JJaroll/MacBerry-Pi/docs/README.md

# Documentación

- [`guia_cableado_pi5.md`](guia_cableado_pi5.md) · cableado, pines verificados contra KiCad, jumpers, Raspberry Pi 5, alimentación y pruebas.
- [`guia_macberry_pi.md`](guia_macberry_pi.md) · guía completa de implementación (traducción y adaptación; revisa sus tablas de pines contra la guía anterior).
- [`informe_master_v5.md`](informe_master_v5.md) · informe del PCB master (diseño, comprobaciones, antes de fabricar, logos).
- [`traducciones/`](traducciones) · material del proyecto original traducido al español (README, readmes de carpetas, utilidad de calibración, modelines).
- [`historial/`](historial) · informes de las versiones anteriores (fusión, v2, v3, v4).

Documentación original en inglés: [qbancoffee/imac_g3_ivad_board_init](https://github.com/qbancoffee/imac_g3_ivad_board_init).
