JJaroll/MacBerry-Pi/hardware/contribuciones_rudy/LEEME.md

# Contribuciones de Rudy (reng.ca)

Placas creadas y cedidas por **Rudy** ([reng.ca](https://reng.ca)) al proyecto de qbancoffee para que otros las usen. KiCad (esquema, PCB, Gerber, PDF), sin modificar.

- **RPiG3iMac**: HAT para Raspberry Pi con LEDs de encendido y actividad. Convierte el RS232 TTL entrante a niveles CMOS para el puerto serie de la Pi.
- **RPiG3iMacJ20**: placa adaptadora para las tiras de pines J3 y J5 de la placa J20; permite conectar cables comunes mediante regleta de terminales.

Texto original en inglés traducido: *«Estas placas fueron creadas y generosamente aportadas por Rudy…»* (ver `readme.txt`, ya en español).
