JJaroll/MacBerry-Pi/originales/surfacemount_version/LEEME.md

# Versión SMD de la placa J20 (en desarrollo)

Copia de `schematics_and_pcbs/surfacemount_version` de qbancoffee: versión de montaje superficial de las placas principales, pensada para servicios de ensamblado. Según el autor **está en desarrollo**, por lo que no se ha verificado en este repositorio. Sin modificar (LGPL-3.0).
