JJaroll/MacBerry-Pi/hardware/placas_individuales/DownConverter/esquematico_es/LEEME.md

# Esquema traducido

Archivos KiCad 5 (`.sch`, `-cache.lib`, `.pro`) y BOM del proyecto de qbancoffee con las etiquetas traducidas al español. Para abrirlos usa KiCad 5 o importa el `.sch` en versiones posteriores.
