JJaroll/MacBerry-Pi/originales/imagenes/LEEME.md

# Imágenes del proyecto original

Imágenes de [qbancoffee/imac_g3_ivad_board_init](https://github.com/qbancoffee/imac_g3_ivad_board_init) (LGPL-3.0) usadas por la guía y por el README traducido. Los PNG están optimizados y las **fotos JPG reducidas a un máximo de 1600 px** para aligerar el repositorio; los originales a resolución completa están en el repositorio de qbancoffee.
