JJaroll/MacBerry-Pi/originales/raw_data/LEEME.md

# Datos crudos (raw_data)

Capturas del bus I²C de la placa IVAD (logic analyzer, `captures/`) y volcados EDID (`edids/`) que qbancoffee usó para la ingeniería inversa. Sin modificar (LGPL-3.0); solo se tradujo `captures/display_adjustment_utility/README.txt`. Referencia para quien quiera entender o ampliar la secuencia de inicialización.
