JJaroll/MacBerry-Pi/docs/traducciones/imagenes/analog_board_off.jpg

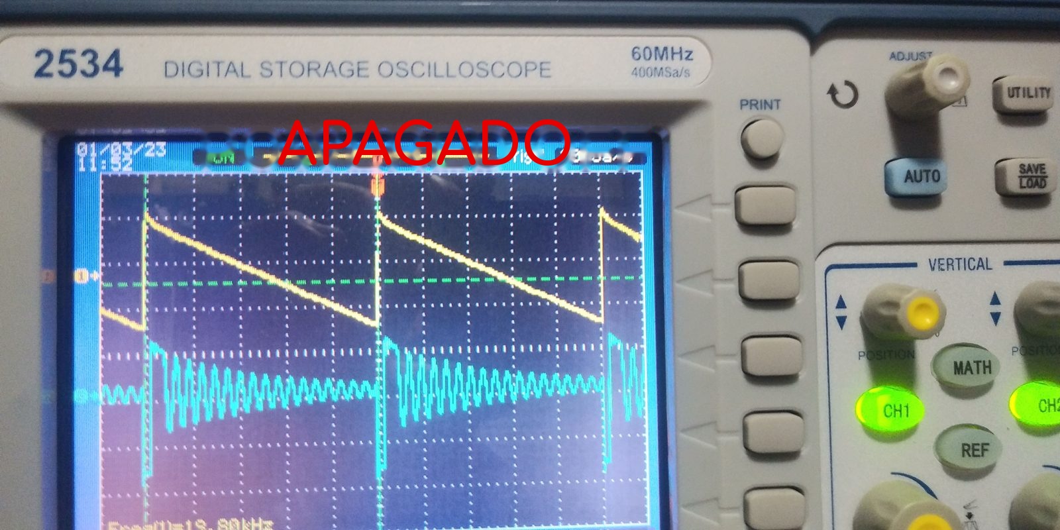
docs/traducciones/imagenes/analog_board_off.jpg
