JJaroll/MacBerry-Pi/docs/traducciones/imagenes/analog_board_on.jpg

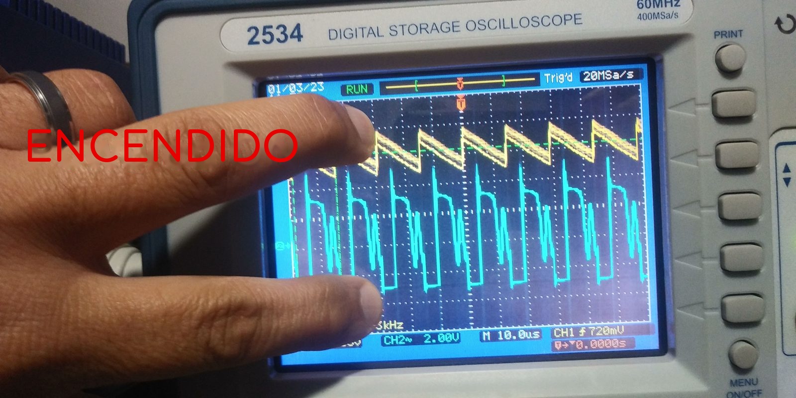
docs/traducciones/imagenes/analog_board_on.jpg
