JJaroll/MacBerry-Pi/docs/traducciones/imagenes/crt_power_on_and_off.png

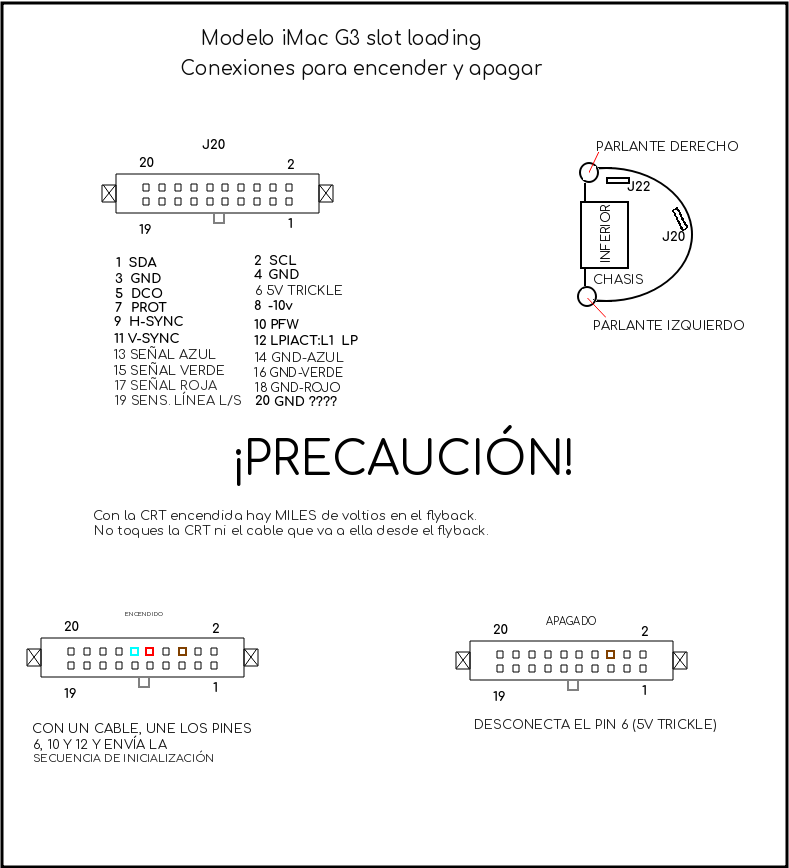
docs/traducciones/imagenes/crt_power_on_and_off.png
