JJaroll/MacBerry-Pi/docs/traducciones/imagenes/J20_and_J22_in_view.jpg

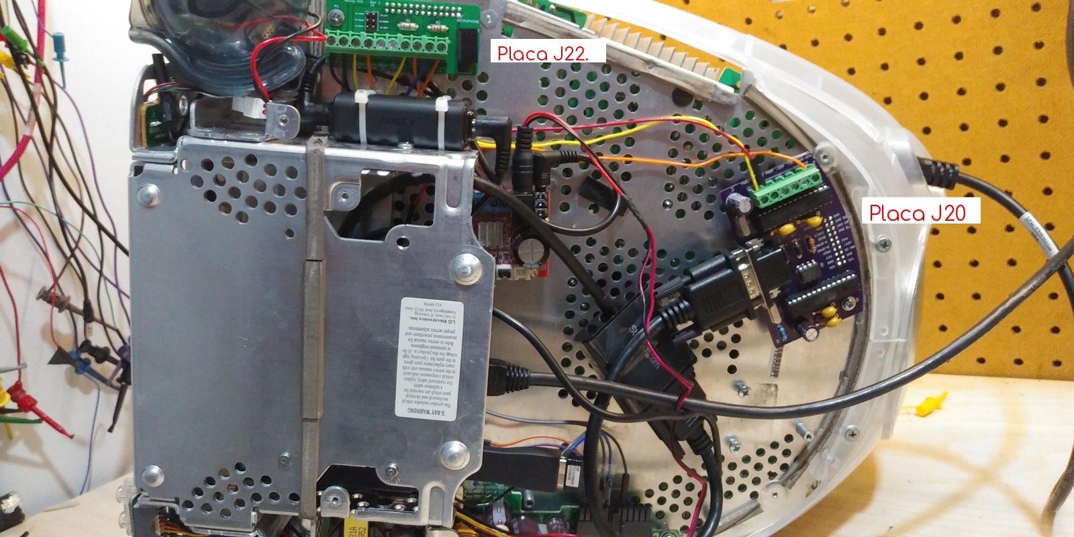
docs/traducciones/imagenes/J20_and_J22_in_view.jpg
