JJaroll/MacBerry-Pi/hardware/master_pcb/vistas_previas/PCB_imac_unificado_master_v5_con_corte_vista_previa.png

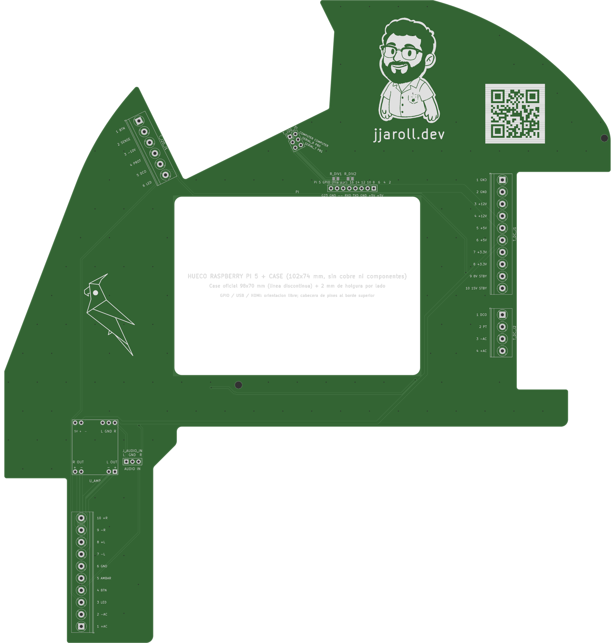
hardware/master_pcb/vistas_previas/PCB_imac_unificado_master_v5_con_corte_vista_previa.png
