JJaroll/MacBerry-Pi/hardware/master_pcb/vistas_previas/PCB_imac_unificado_master_v5_gerber_vista_inferior.png

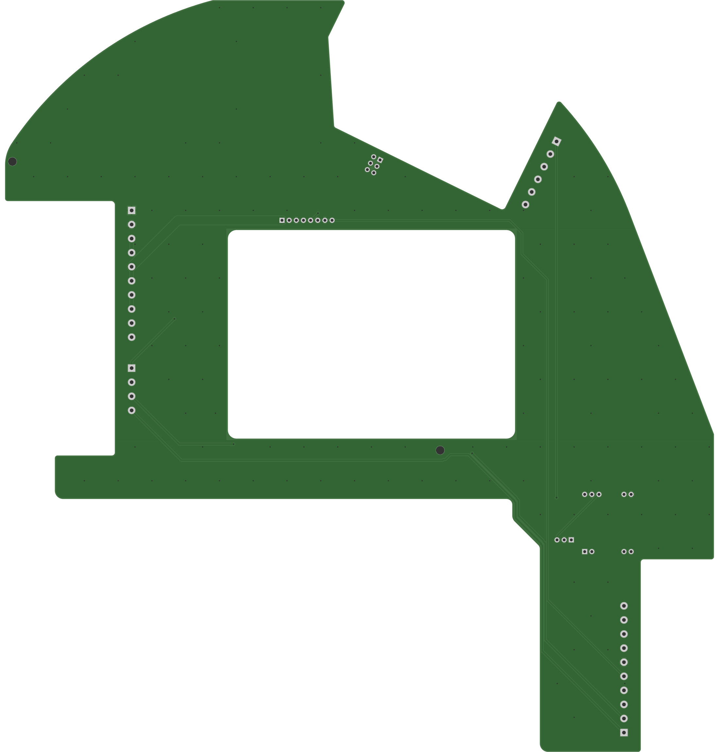
hardware/master_pcb/vistas_previas/PCB_imac_unificado_master_v5_gerber_vista_inferior.png
