JJaroll/MacBerry-Pi/originales/imagenes/down_converter_breakout.jpg

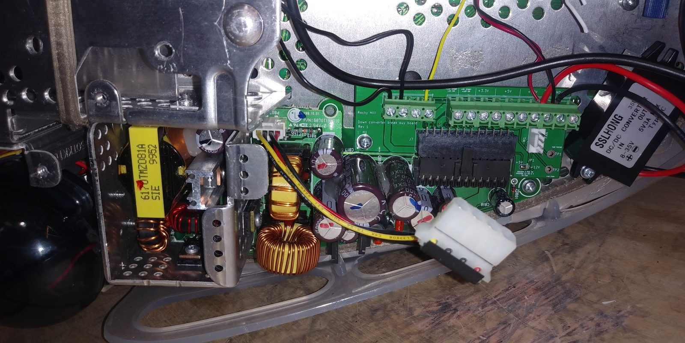
originales/imagenes/down_converter_breakout.jpg
