JJaroll/MacBerry-Pi/originales/imagenes/j20_board.jpg

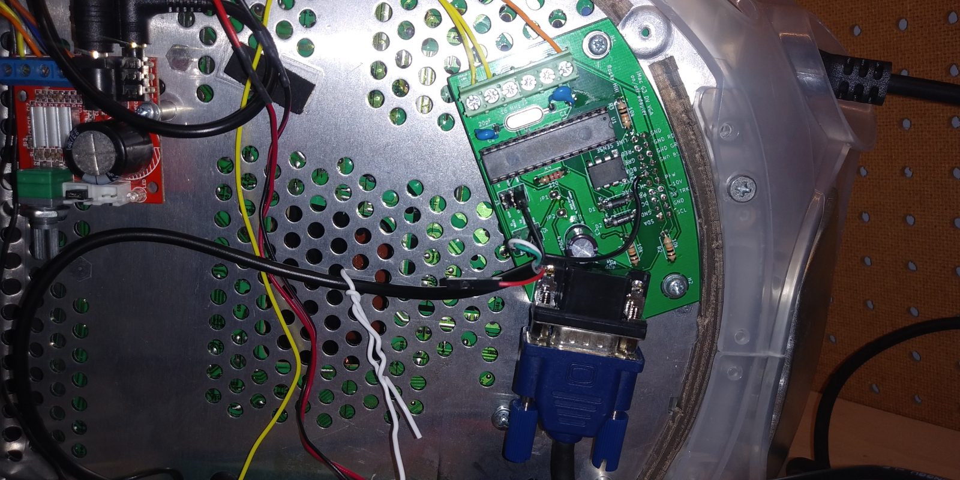
originales/imagenes/j20_board.jpg
