JJaroll/MacBerry-Pi/originales/imagenes/j22_board.jpg

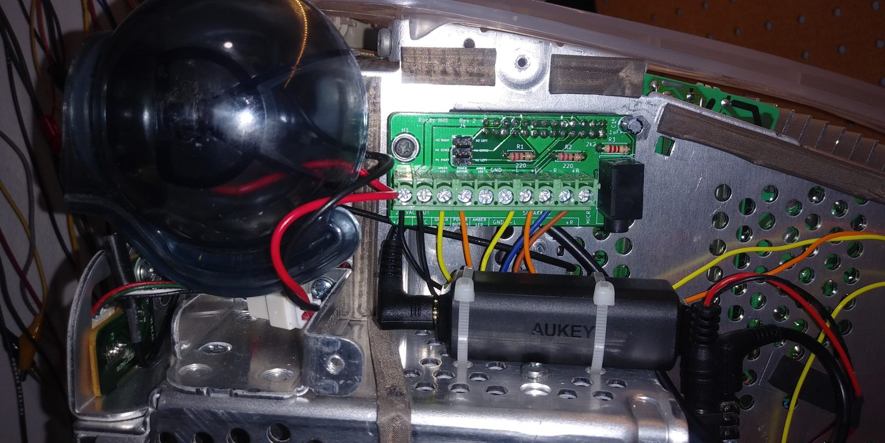
originales/imagenes/j22_board.jpg
