JJaroll/MacBerry-Pi/originales/raw_data/captures/display_adjustment_utility/color/color.jpg

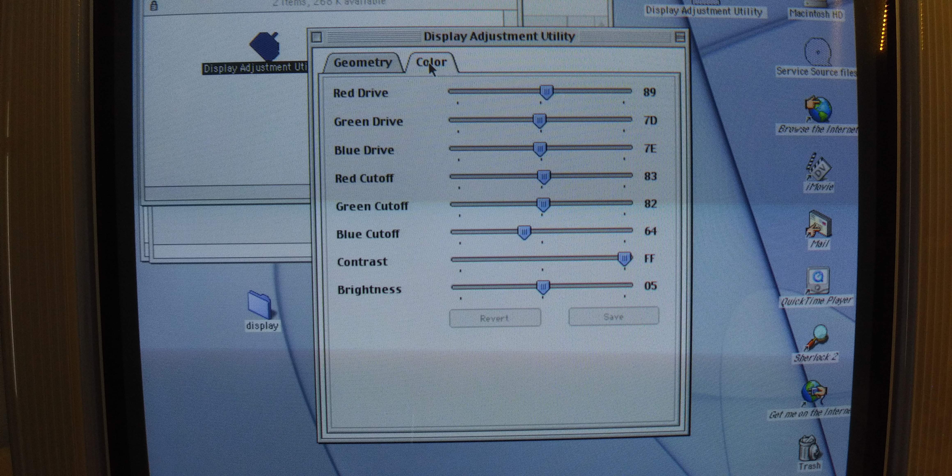
originales/raw_data/captures/display_adjustment_utility/color/color.jpg
