JJaroll/MacBerry-Pi/originales/raw_data/captures/display_adjustment_utility/geometry/geometry.jpg

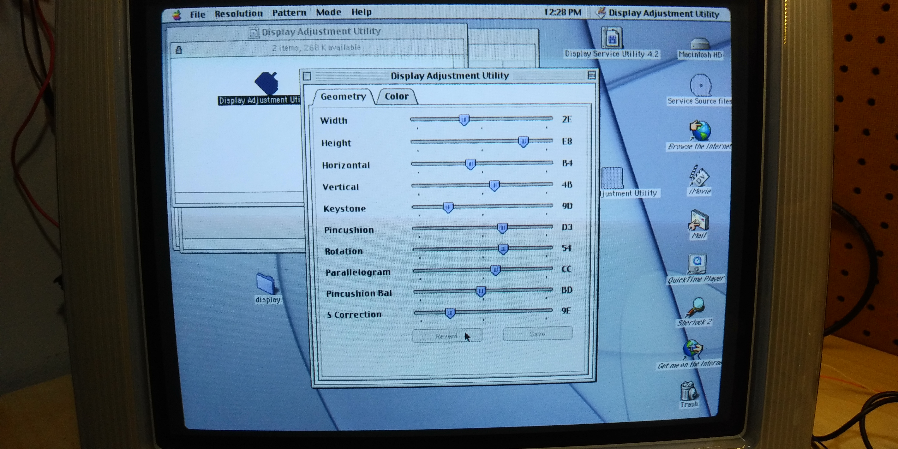
originales/raw_data/captures/display_adjustment_utility/geometry/geometry.jpg
