JJaroll/MacBerry-Pi/sitio/img/placa_dc_inf.png

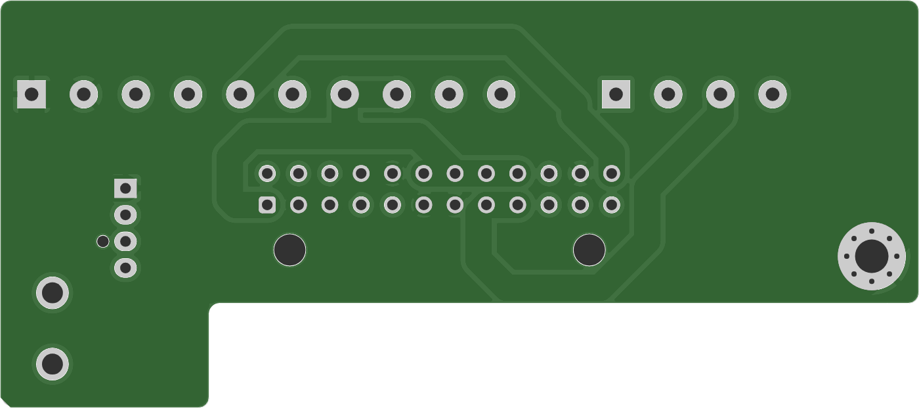
sitio/img/placa_dc_inf.png
