JJaroll/MacBerry-Pi/sitio/img/placa_dc_sup.png

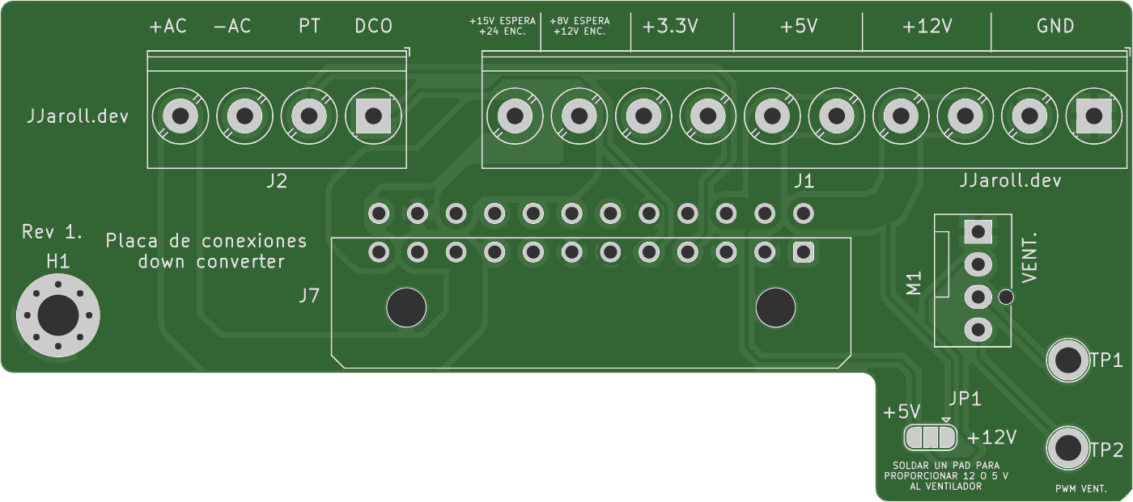
sitio/img/placa_dc_sup.png
