JJaroll/MacBerry-Pi/sitio/img/placa_j20_inf.png

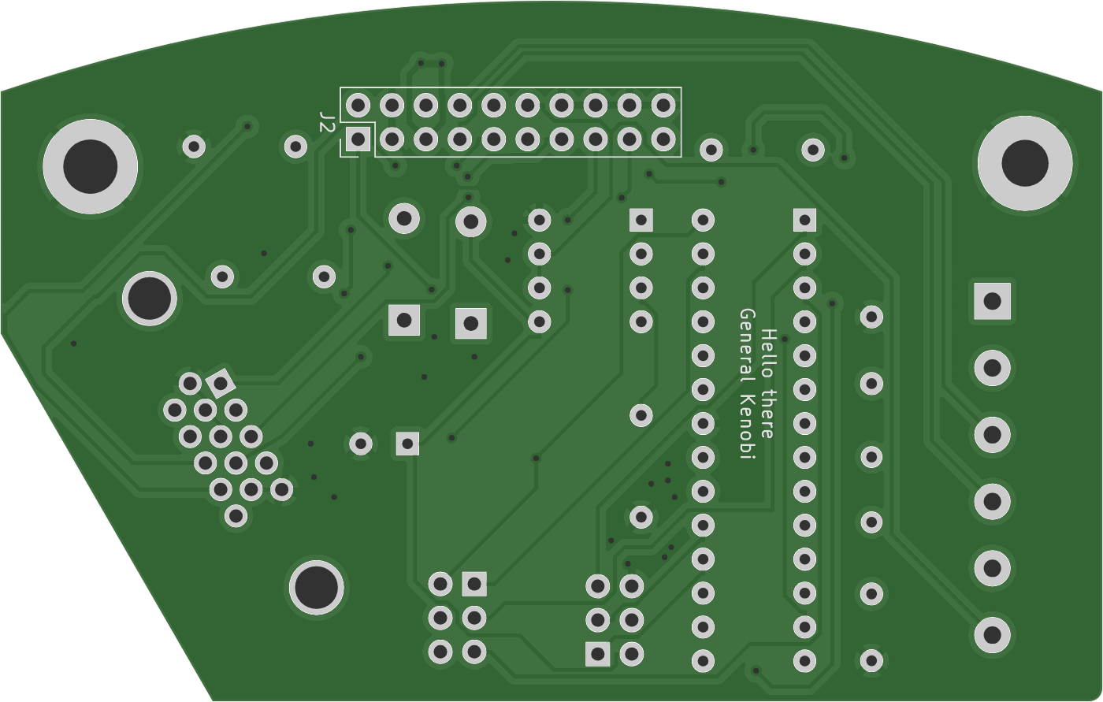
sitio/img/placa_j20_inf.png
