JJaroll/MacBerry-Pi/sitio/img/placa_j20_sup.png

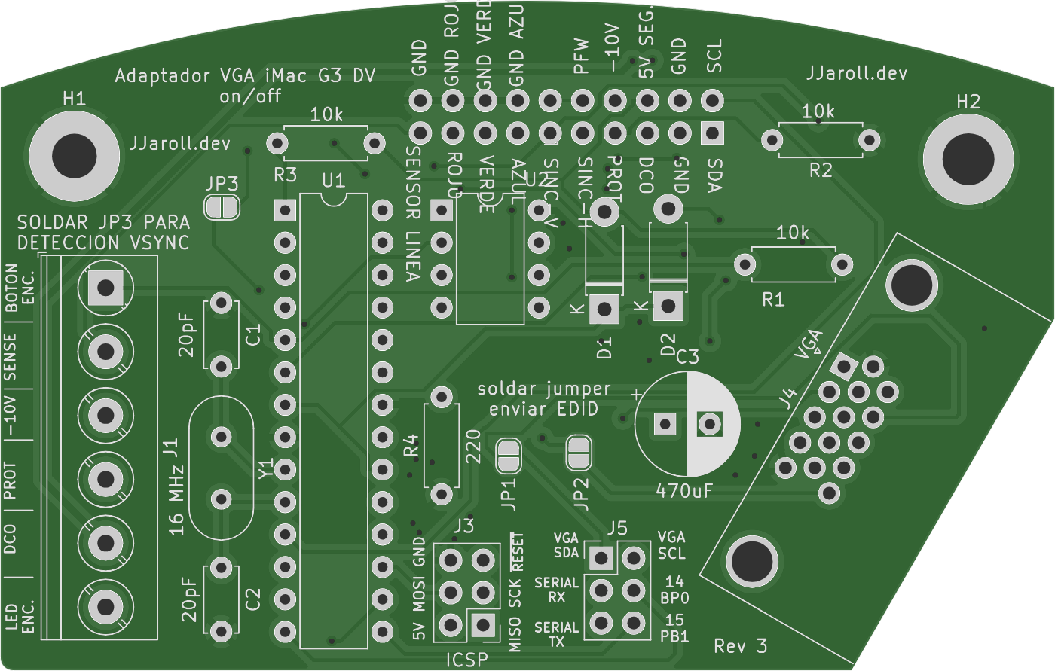
sitio/img/placa_j20_sup.png
