JJaroll/MacBerry-Pi/sitio/img/placa_j22_inf.png

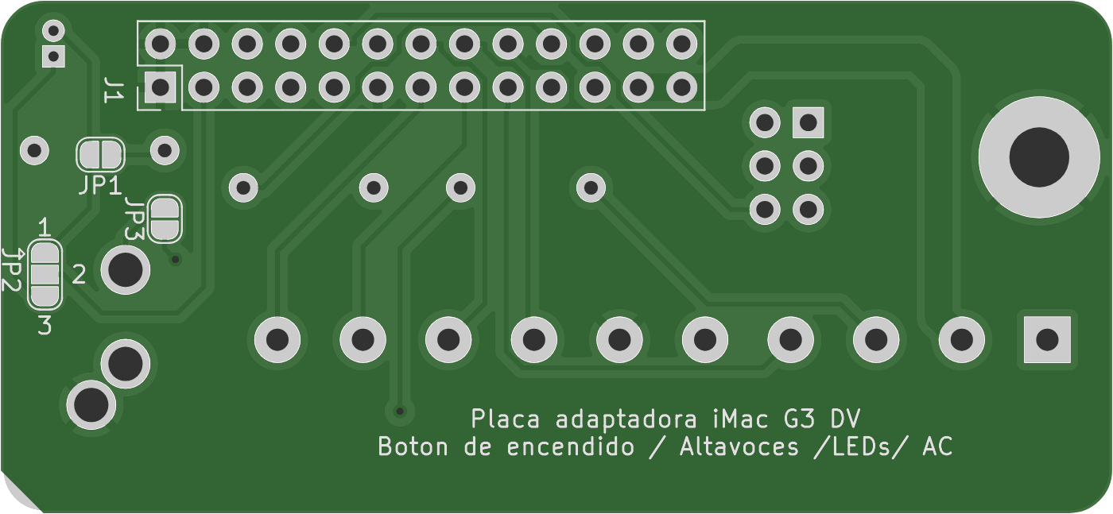
sitio/img/placa_j22_inf.png
