JJaroll/MacBerry-Pi/sitio/img/placa_j22_sup.png

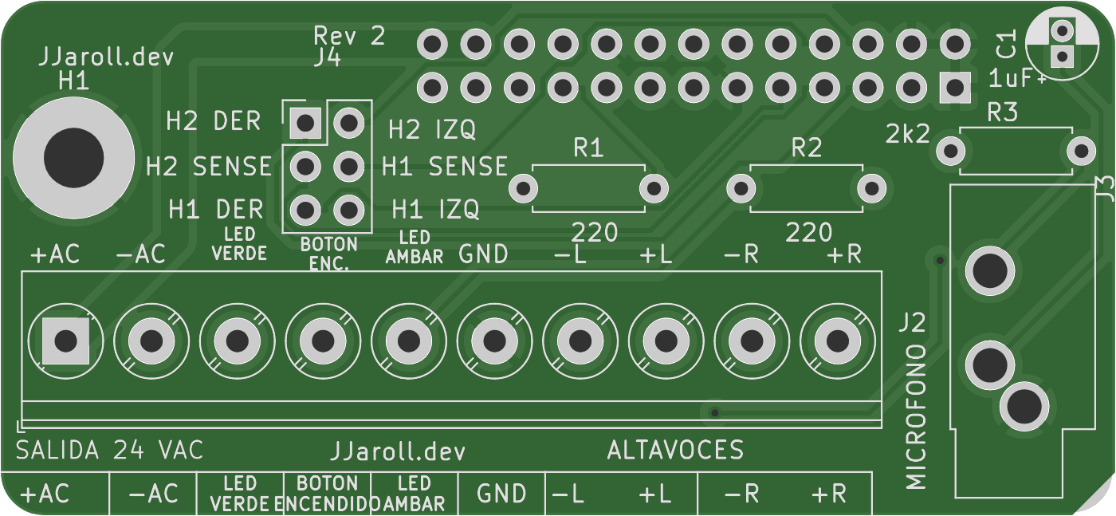
sitio/img/placa_j22_sup.png
