JJaroll/MacBerry-Pi/hardware/placas_individuales/DownConverter/fabricacion/imac_g3_down_converter_board_adapter.csv

Id | Identificador | Huella | Cantidad | Identificación | Suministrador y ref
1 | J1 | TerminalBlock_Phoenix_PT-1,5-10-5.0-H_1x10_P5.00mm_Horizontal | 1 | Screw_Terminal_01x10
2 | J2 | TerminalBlock_Phoenix_PT-1,5-4-5.0-H_1x04_P5.00mm_Horizontal | 1 | Screw_Terminal_01x04
3 | J7 | Molex_Micro-Fit_3.0_43045-2400_2x12_P3.00mm_Horizontal | 1 | Conn_02x12_Top_Bottom
4 | M1 | FanPinHeader_1x04_P2.54mm_Vertical | 1 | Fan_Tacho_PWM
