JJaroll/MacBerry-Pi/hardware/placas_individuales/J22_frontal_audio/fabricacion/imac_g3_slot_loading_J22_adapter_board.csv

Id | Identificador | Huella | Cantidad | Identificación | Suministrador y ref
1 | C1 | CP_Radial_D4.0mm_P1.50mm | 1 | 1uF
2 | J1 | PinHeader_2x13_P2.54mm_Vertical | 1 | Conn_02x13_Odd_Even
3 | J2 | TerminalBlock_Phoenix_PT-1,5-10-5.0-H_1x10_P5.00mm_Horizontal | 1 | Screw_Terminal_01x10
4 | J3 | Jack_3.5mm_CUI_SJ1-3533NG_Horizontal_CircularHoles | 1 | AudioJack3
5 | J4 | PinHeader_2x03_P2.54mm_Vertical | 1 | Conn_02x03_Odd_Even
6 | R1, R2 | R_Axial_DIN0207_L6.3mm_D2.5mm_P7.62mm_Horizontal | 2 | 220
7 | R3 | R_Axial_DIN0207_L6.3mm_D2.5mm_P7.62mm_Horizontal | 1 | 2.2k
