JJaroll/MacBerry-Pi/hardware/master_pcb/PCB_imac_unificado_master_v5_contorno_1a1.dxf

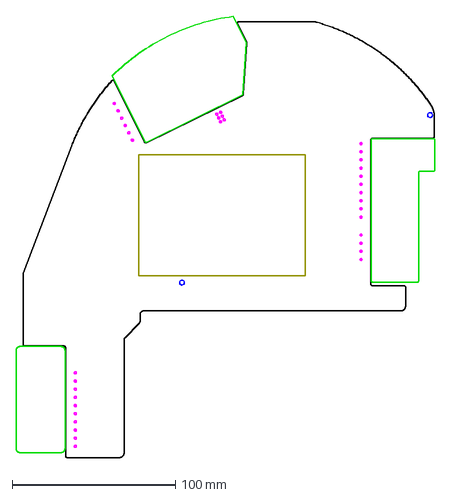
[picture p62: CAD file, 2026-10-20]
hardware/master_pcb/PCB_imac_unificado_master_v5_contorno_1a1.dxf
256.5 x 270.1 mm
