JJaroll/MacBerry-Pi/stl/bezel/Dowel_Bottom.stl

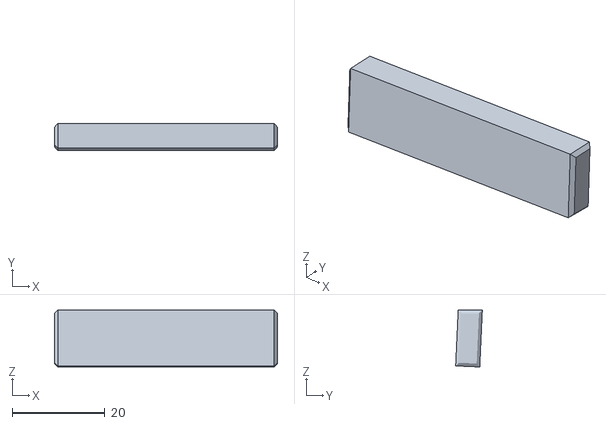
[picture p63: CAD file, 2026-10-20]
stl/bezel/Dowel_Bottom.stl
48.0 x 5.75 x 12.3
