JJaroll/MacBerry-Pi/stl/pcb/placa_DownConverter.stl

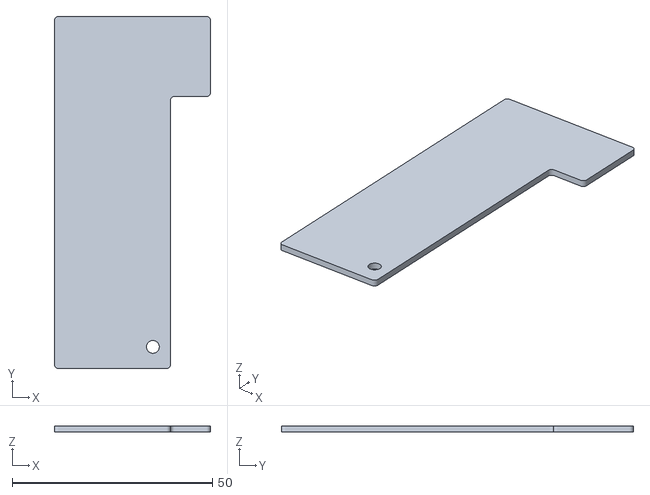
[picture p64: CAD file, 2026-10-20]
stl/pcb/placa_DownConverter.stl
39.0 x 88.0 x 1.60
