JJaroll/MacBerry-Pi/stl/rpi_mount/rpi_g3_plate_v2.stl

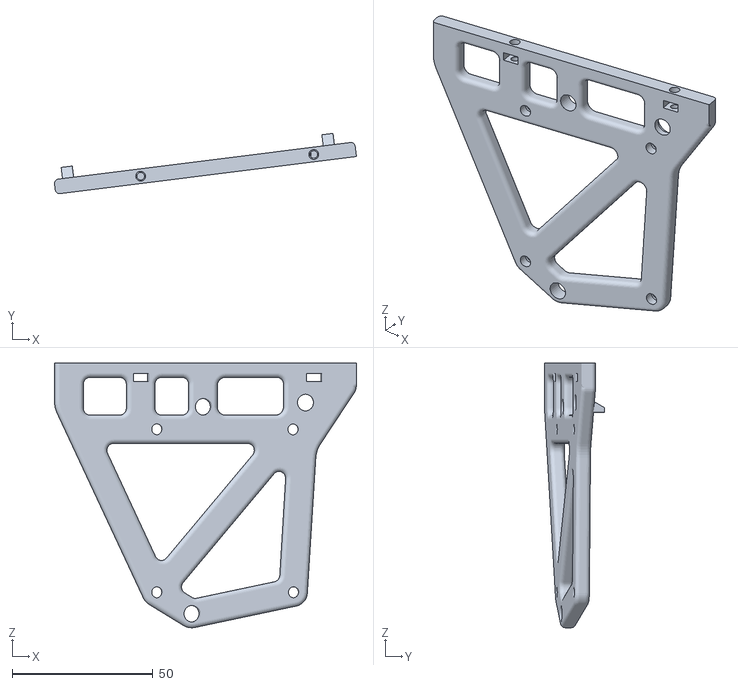
[picture p65: CAD file, 2026-10-20]
stl/rpi_mount/rpi_g3_plate_v2.stl
107.5 x 21.4 x 94.1
