JJaroll/MacBerry-Pi/originales/proyecto_kicad_original/imac_g3_down_converter_board_adapter/3d_models/CUI_DEVICES_SJ1-3533NG.step

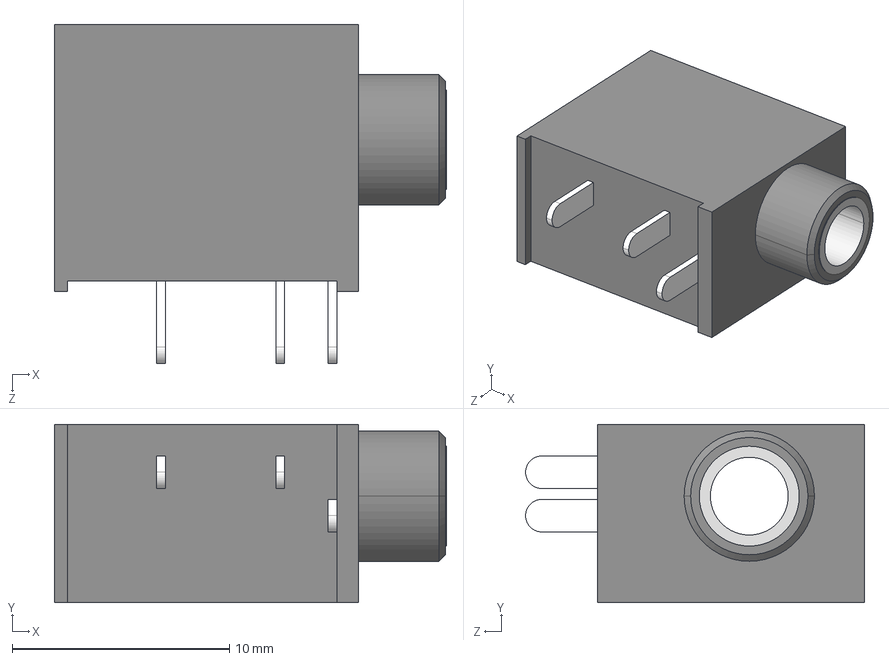
[picture p66: CAD file, 2026-10-20]
originales/proyecto_kicad_original/imac_g3_down_converter_board_adapter/3d_models/CUI_DEVICES_SJ1-3533NG.step
18.1 x 8.20 x 15.6 mm
