JJaroll/MacBerry-Pi/originales/surfacemount_version/imac_g3_333mhz_slot_loading_J20_adapter_board/3d_models/usb_c_connector_105450-0101.step

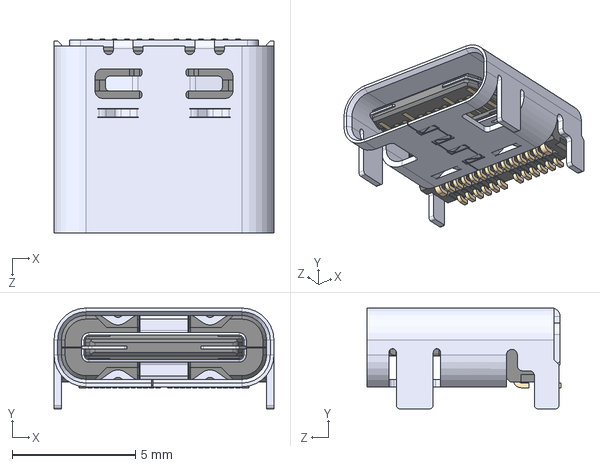
[picture p67: CAD file, 2026-10-20]
originales/surfacemount_version/imac_g3_333mhz_slot_loading_J20_adapter_board/3d_models/usb_c_connector_105450-0101.step
8.94 x 4.10 x 7.90 mm
