JJaroll/MacBerry-Pi/stl/bezel/Top_Right_Supported.stl

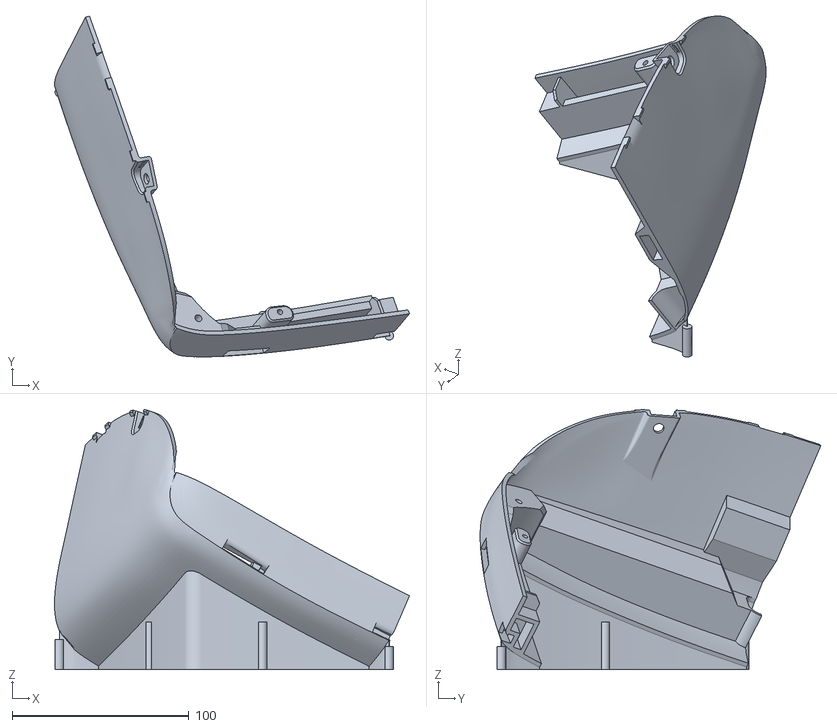
[picture p68: CAD file, 2026-10-20]
stl/bezel/Top_Right_Supported.stl
201.0 x 192.9 x 147.3
