JJaroll/MacBerry-Pi/stl/pcb/master_v5_con_corte.stl

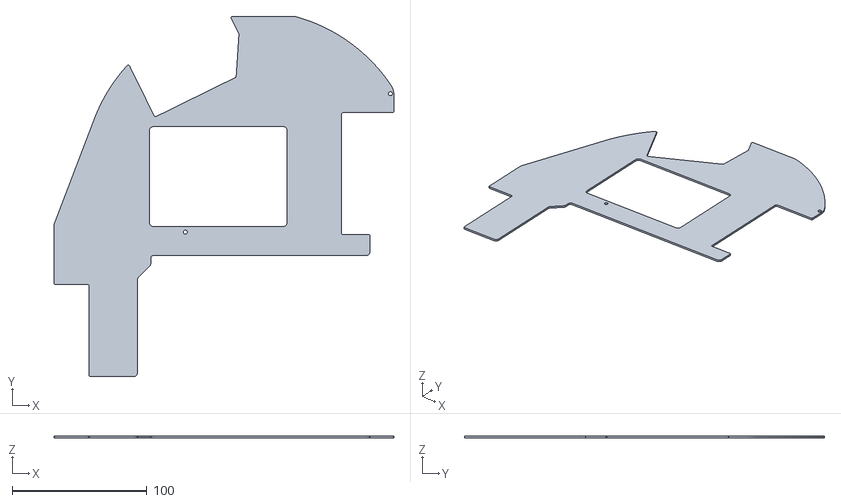
[picture p69: CAD file, 2026-10-20]
stl/pcb/master_v5_con_corte.stl
251.9 x 267.0 x 1.60
