JJaroll/MacBerry-Pi/stl/rpi_mount/rpi_g3_spacer_v1.stl

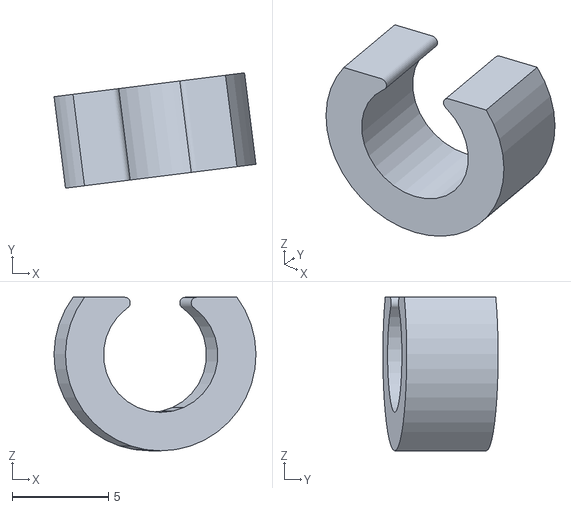
[picture p70: CAD file, 2026-10-20]
stl/rpi_mount/rpi_g3_spacer_v1.stl
10.5 x 6.01 x 8.00
