JJaroll/MacBerry-Pi/originales/surfacemount_version/imac_g3_333mhz_slot_loading_J20_adapter_board/3d_models/USB4105-GF-A.step

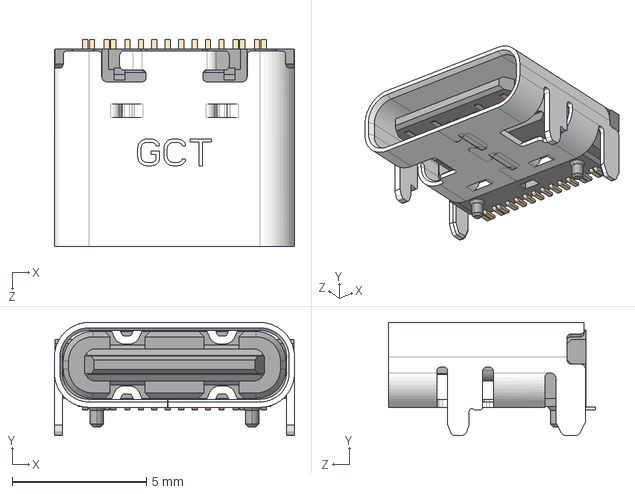
[picture p71: CAD file, 2026-10-20]
originales/surfacemount_version/imac_g3_333mhz_slot_loading_J20_adapter_board/3d_models/USB4105-GF-A.step
8.94 x 4.21 x 7.70 mm
HSG_默认
