JJaroll/MacBerry-Pi/stl/pcb/placa_J22_frontal_audio.stl

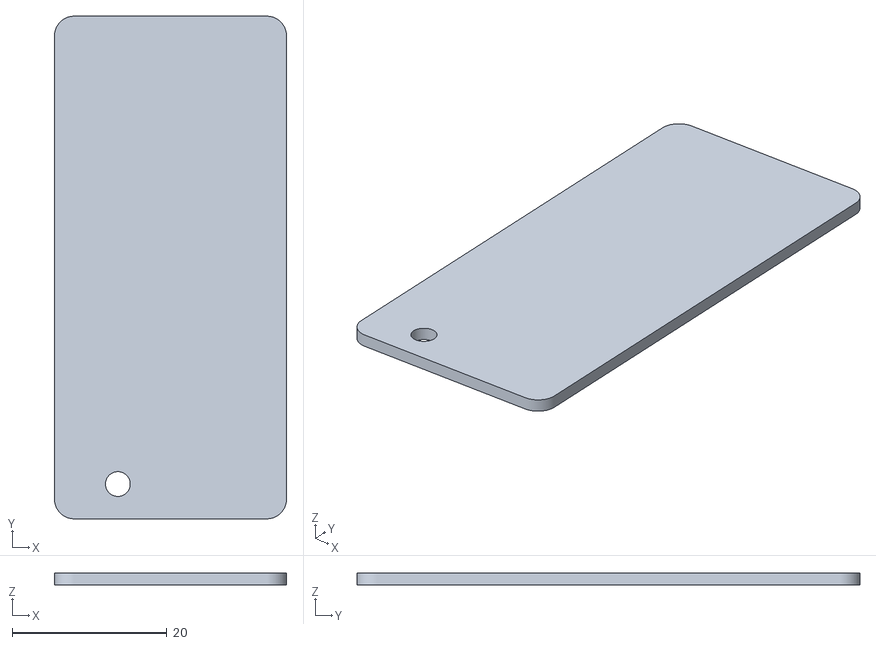
[picture p72: CAD file, 2026-10-20]
stl/pcb/placa_J22_frontal_audio.stl
30.0 x 65.0 x 1.60
