JJaroll/MacBerry-Pi/stl/rpi_mount/rpi_g3_bezel_v3.stl

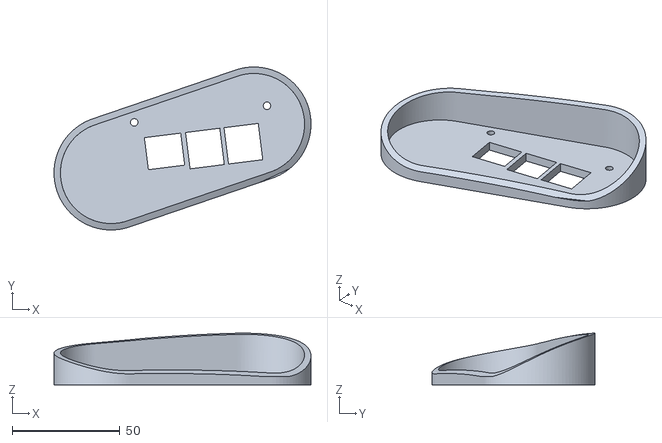
[picture p73: CAD file, 2026-10-20]
stl/rpi_mount/rpi_g3_bezel_v3.stl
119.2 x 75.6 x 24.0
