JJaroll/MacBerry-Pi/stl/pcb/placa_J20_video.stl

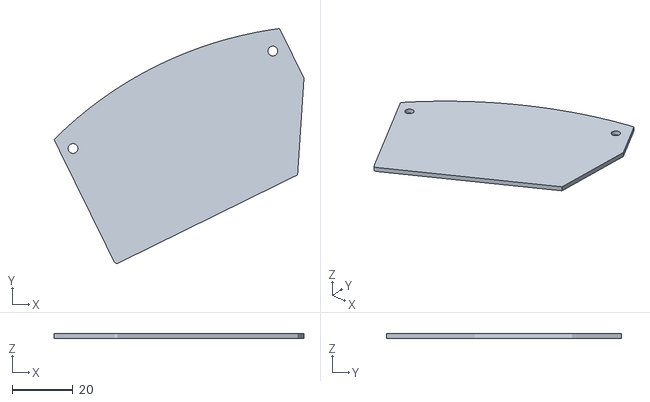
[picture p74: CAD file, 2026-10-20]
stl/pcb/placa_J20_video.stl
82.1 x 77.1 x 1.60
