JJaroll/MacBerry-Pi/stl/bezel/Top_Left.stl

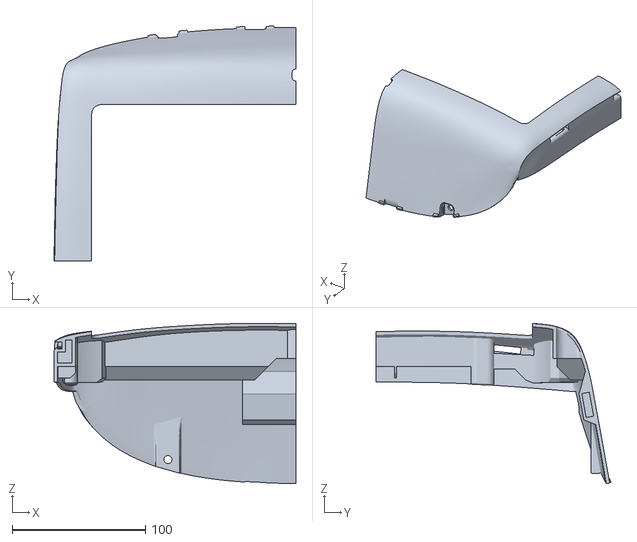
[picture p75: CAD file, 2026-10-20]
stl/bezel/Top_Left.stl
181.3 x 176.0 x 120.2
