JJaroll/MacBerry-Pi/stl/bezel/Power_Button.stl

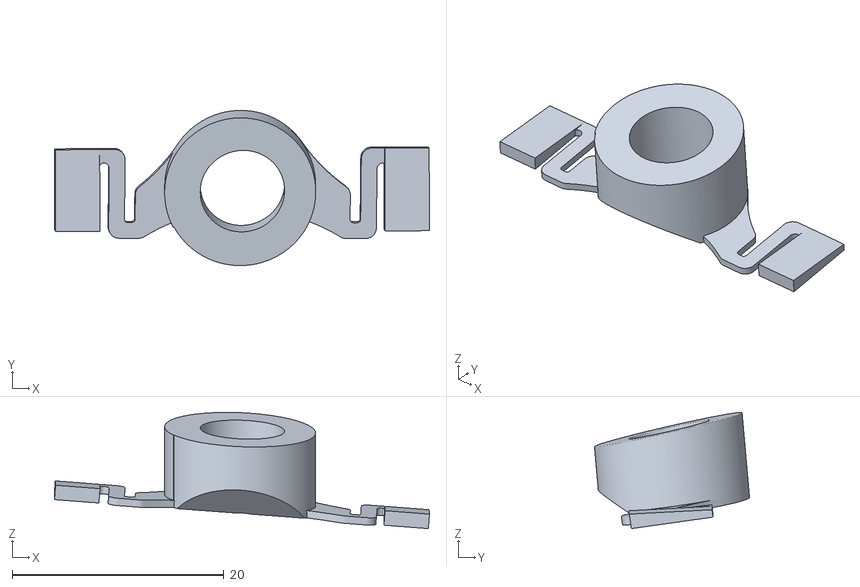
[picture p76: CAD file, 2026-10-20]
stl/bezel/Power_Button.stl
35.4 x 14.6 x 11.0
