JJaroll/MacBerry-Pi/stl/bezel/Dowel_Right.stl

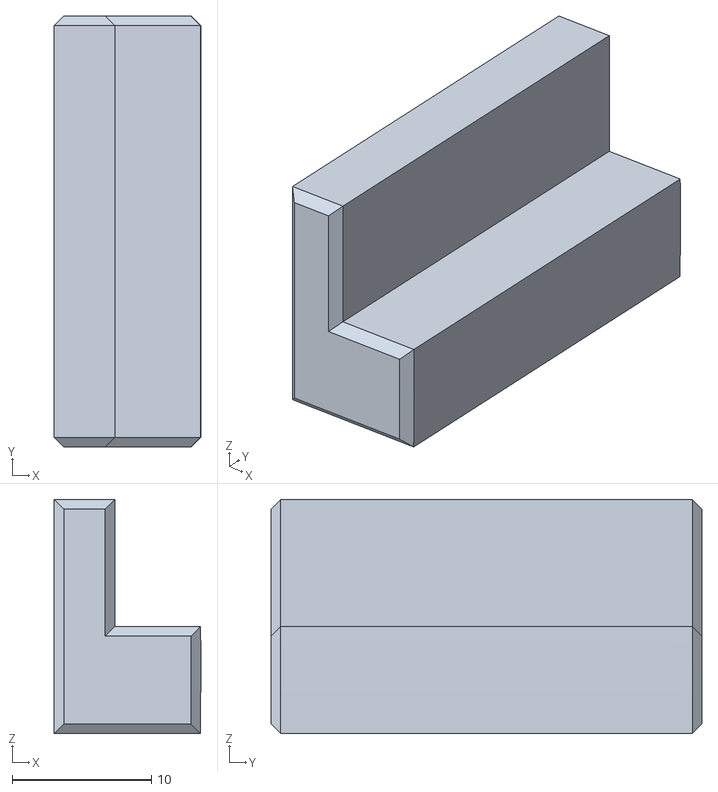
[picture p77: CAD file, 2026-10-20]
stl/bezel/Dowel_Right.stl
10.6 x 31.0 x 16.8
