JJaroll/MacBerry-Pi/stl/bezel/Bottom_Right_Supported.stl

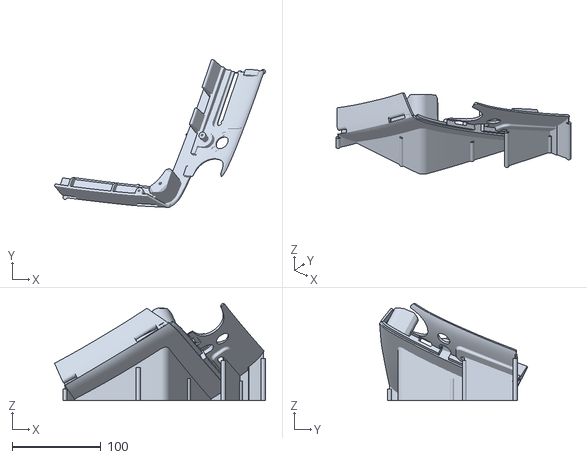
[picture p78: CAD file, 2026-10-20]
stl/bezel/Bottom_Right_Supported.stl
237.1 x 166.3 x 109.1
