JJaroll/MacBerry-Pi/stl/bezel/Dowel_Top.stl

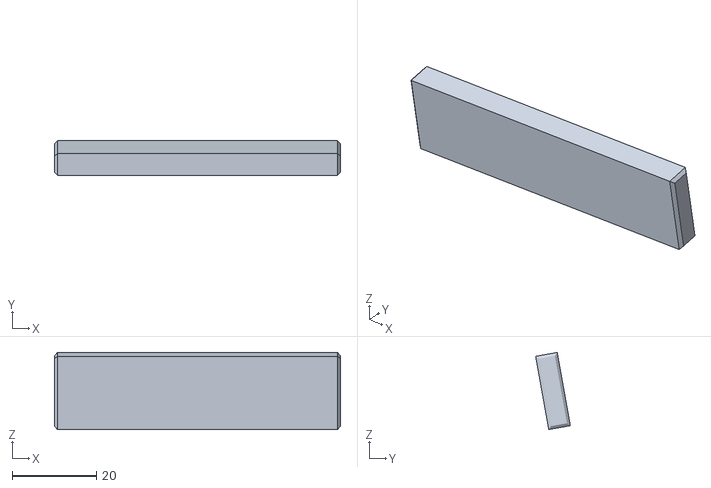
[picture p79: CAD file, 2026-10-20]
stl/bezel/Dowel_Top.stl
68.0 x 8.27 x 18.3
