JJaroll/MacBerry-Pi/stl/bezel/Bottom_Right.stl

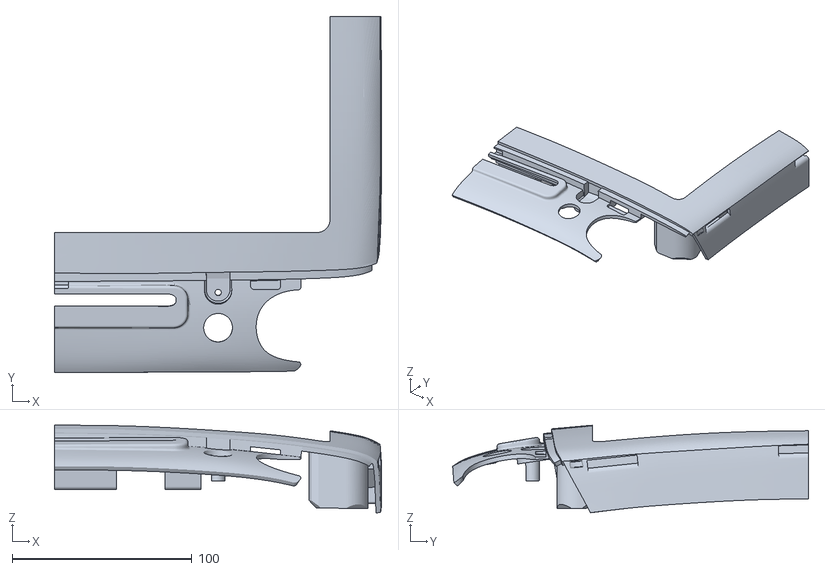
[picture p80: CAD file, 2026-10-20]
stl/bezel/Bottom_Right.stl
181.8 x 197.8 x 48.7
