JJaroll/MacBerry-Pi/stl/bezel/Bottom_Left_Supported.stl

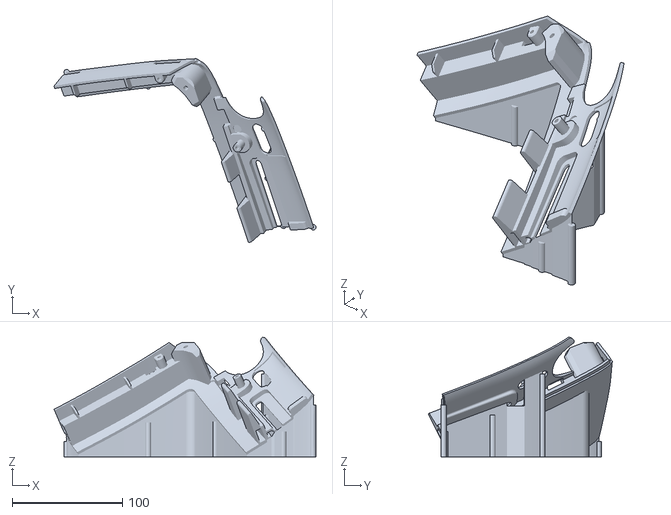
[picture p81: CAD file, 2026-10-20]
stl/bezel/Bottom_Left_Supported.stl
237.8 x 166.8 x 108.6
