JJaroll/MacBerry-Pi/(list of files, cad)

Other CAD files:
stl/bezel/Top_Left_Supported.stl
stl/bezel/Bottom_Left.stl
stl/bezel/Dowel_Left.stl
stl/bezel/Top_Right.stl
originales/proyecto_kicad_original/imac_g3_333mhz_slot_loading_J20_adapter_board/3d_models/Screw Terminal Block 5mm 6-way.step
originales/proyecto_kicad_original/imac_g3_down_converter_board_adapter/3d_models/430452400.stp
originales/proyecto_kicad_original/imac_g3_down_converter_board_adapter/3d_models/EM292902-UL.STEP
originales/proyecto_kicad_original/imac_g3_down_converter_board_adapter/3d_models/Screw Terminal Block 5mm 2-way.step
originales/proyecto_kicad_original/imac_g3_down_converter_board_adapter/3d_models/Screw Terminal Block 5mm 4-way.step
originales/proyecto_kicad_original/imac_g3_down_converter_board_adapter/3d_models/Screw Terminal Block 5mm 6-way.step
originales/proyecto_kicad_original/imac_g3_slot_loading_J22_adapter_board/3d_models/EM292902-UL.STEP
originales/proyecto_kicad_original/imac_g3_slot_loading_J22_adapter_board/3d_models/Screw Terminal Block 5mm 2-way.step
originales/proyecto_kicad_original/imac_g3_slot_loading_J22_adapter_board/3d_models/Screw Terminal Block 5mm 4-way.step
originales/surfacemount_version/imac_g3_333mhz_slot_loading_J20_adapter_board/3d_models/Screw Terminal Block 5mm 6-way.step
stl/bezel/Screw_Cover_Bottom_Left.stl
stl/bezel/Screw_Cover_Bottom_Right.stl
stl/bezel/Screw_Cover_Top_Left.stl
stl/bezel/Screw_Cover_Top_Right.stl
