JJaroll/MacBerry-Pi/docs/traducciones/imagenes/arduino_uno_wiring_to_transmit_edid.png

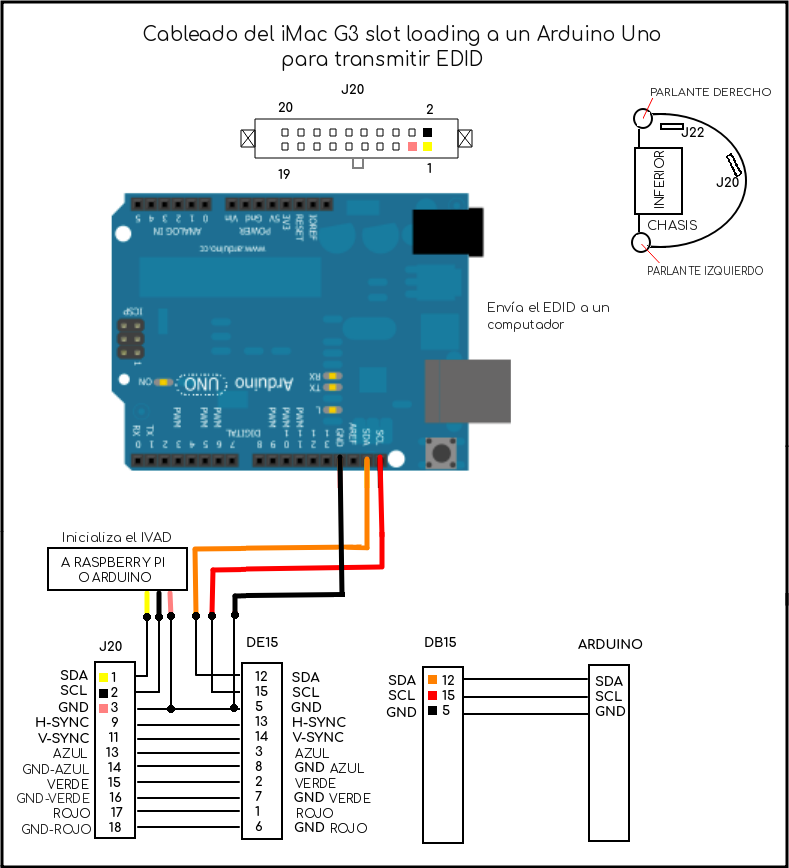
docs/traducciones/imagenes/arduino_uno_wiring_to_transmit_edid.png
