JJaroll/MacBerry-Pi/docs/traducciones/imagenes/basic_wiring.png

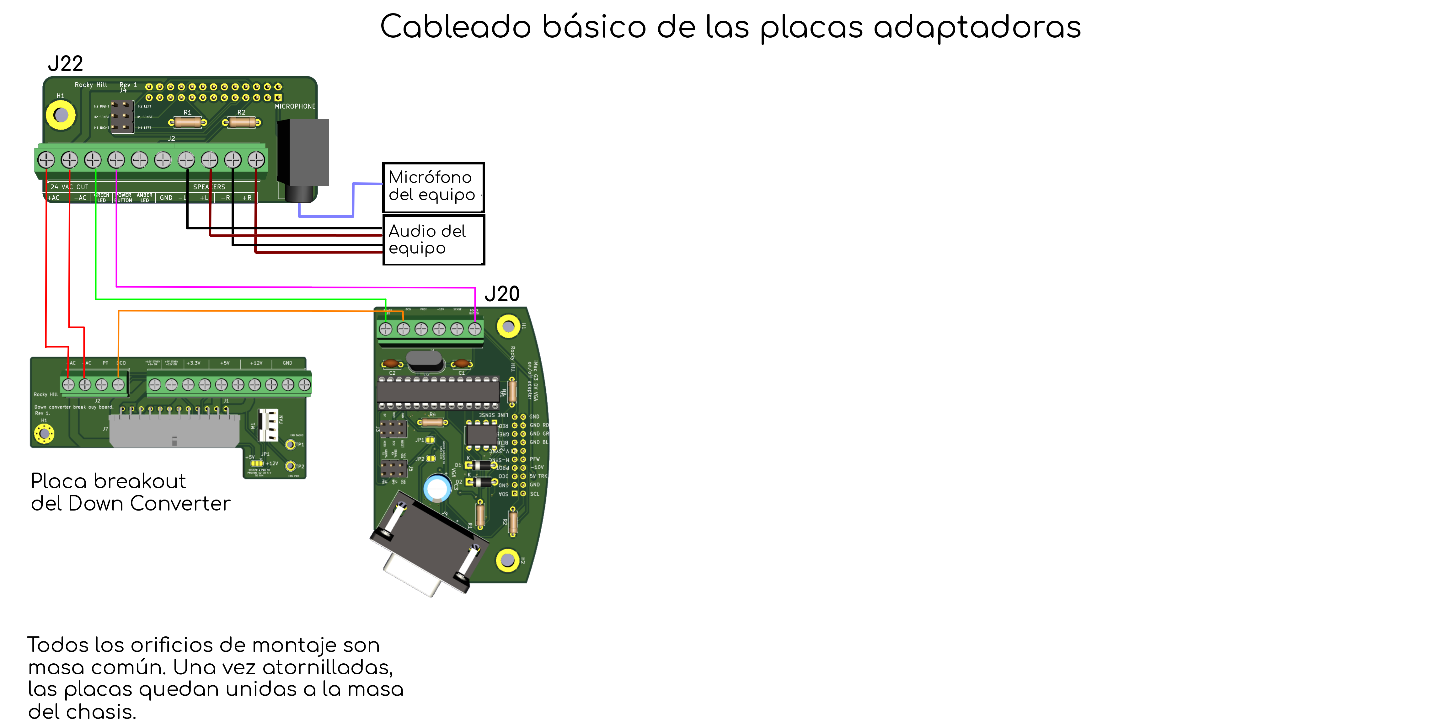
docs/traducciones/imagenes/basic_wiring.png
