JJaroll/MacBerry-Pi/originales/imagenes/basic_wiring.png

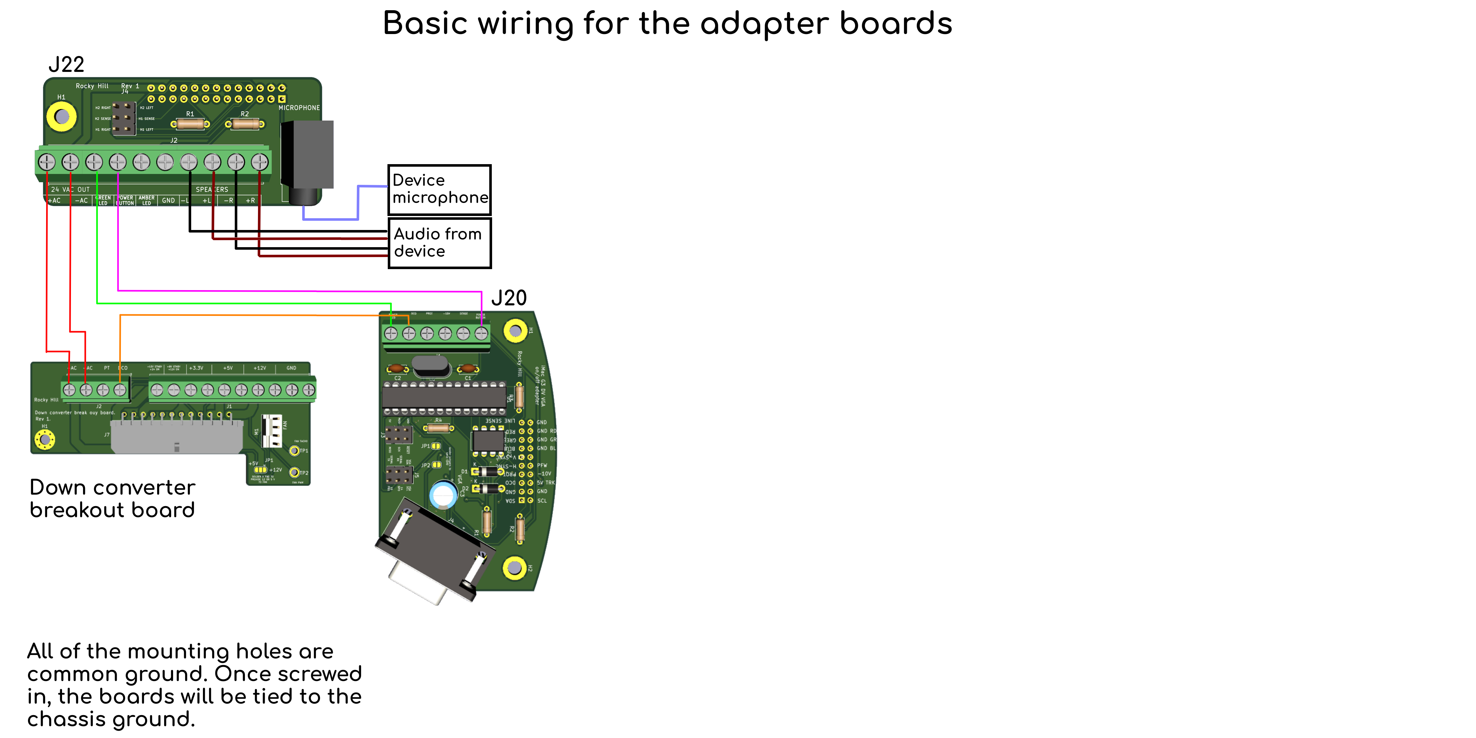
originales/imagenes/basic_wiring.png
