JJaroll/MacBerry-Pi/originales/imagenes/wiring_usb_2_serial_debugger.jpg

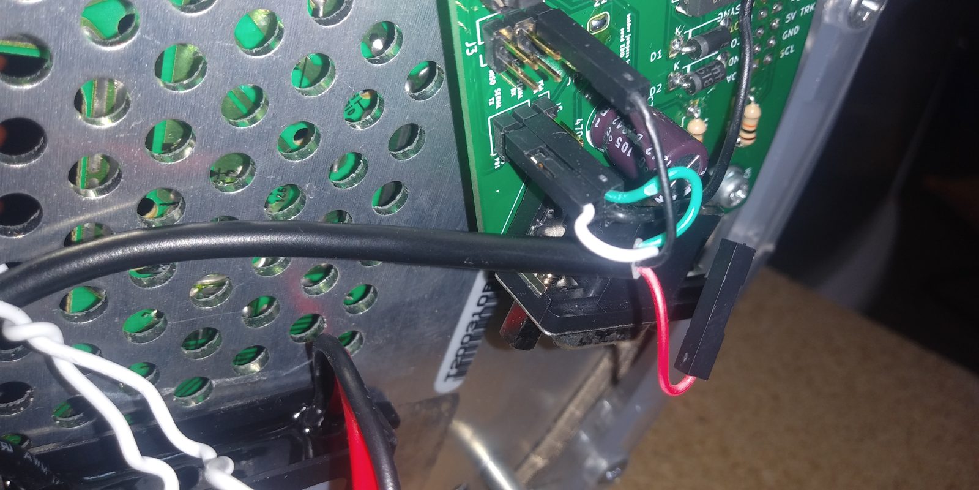
originales/imagenes/wiring_usb_2_serial_debugger.jpg
