JJaroll/MacBerry-Pi/hardware/contribuciones_rudy/RPiG3iMac/RPiG3iMac.kicad_pcb

## KiCad design hardware/contribuciones_rudy/RPiG3iMac/RPiG3iMac.kicad_pcb (2026-10-20)

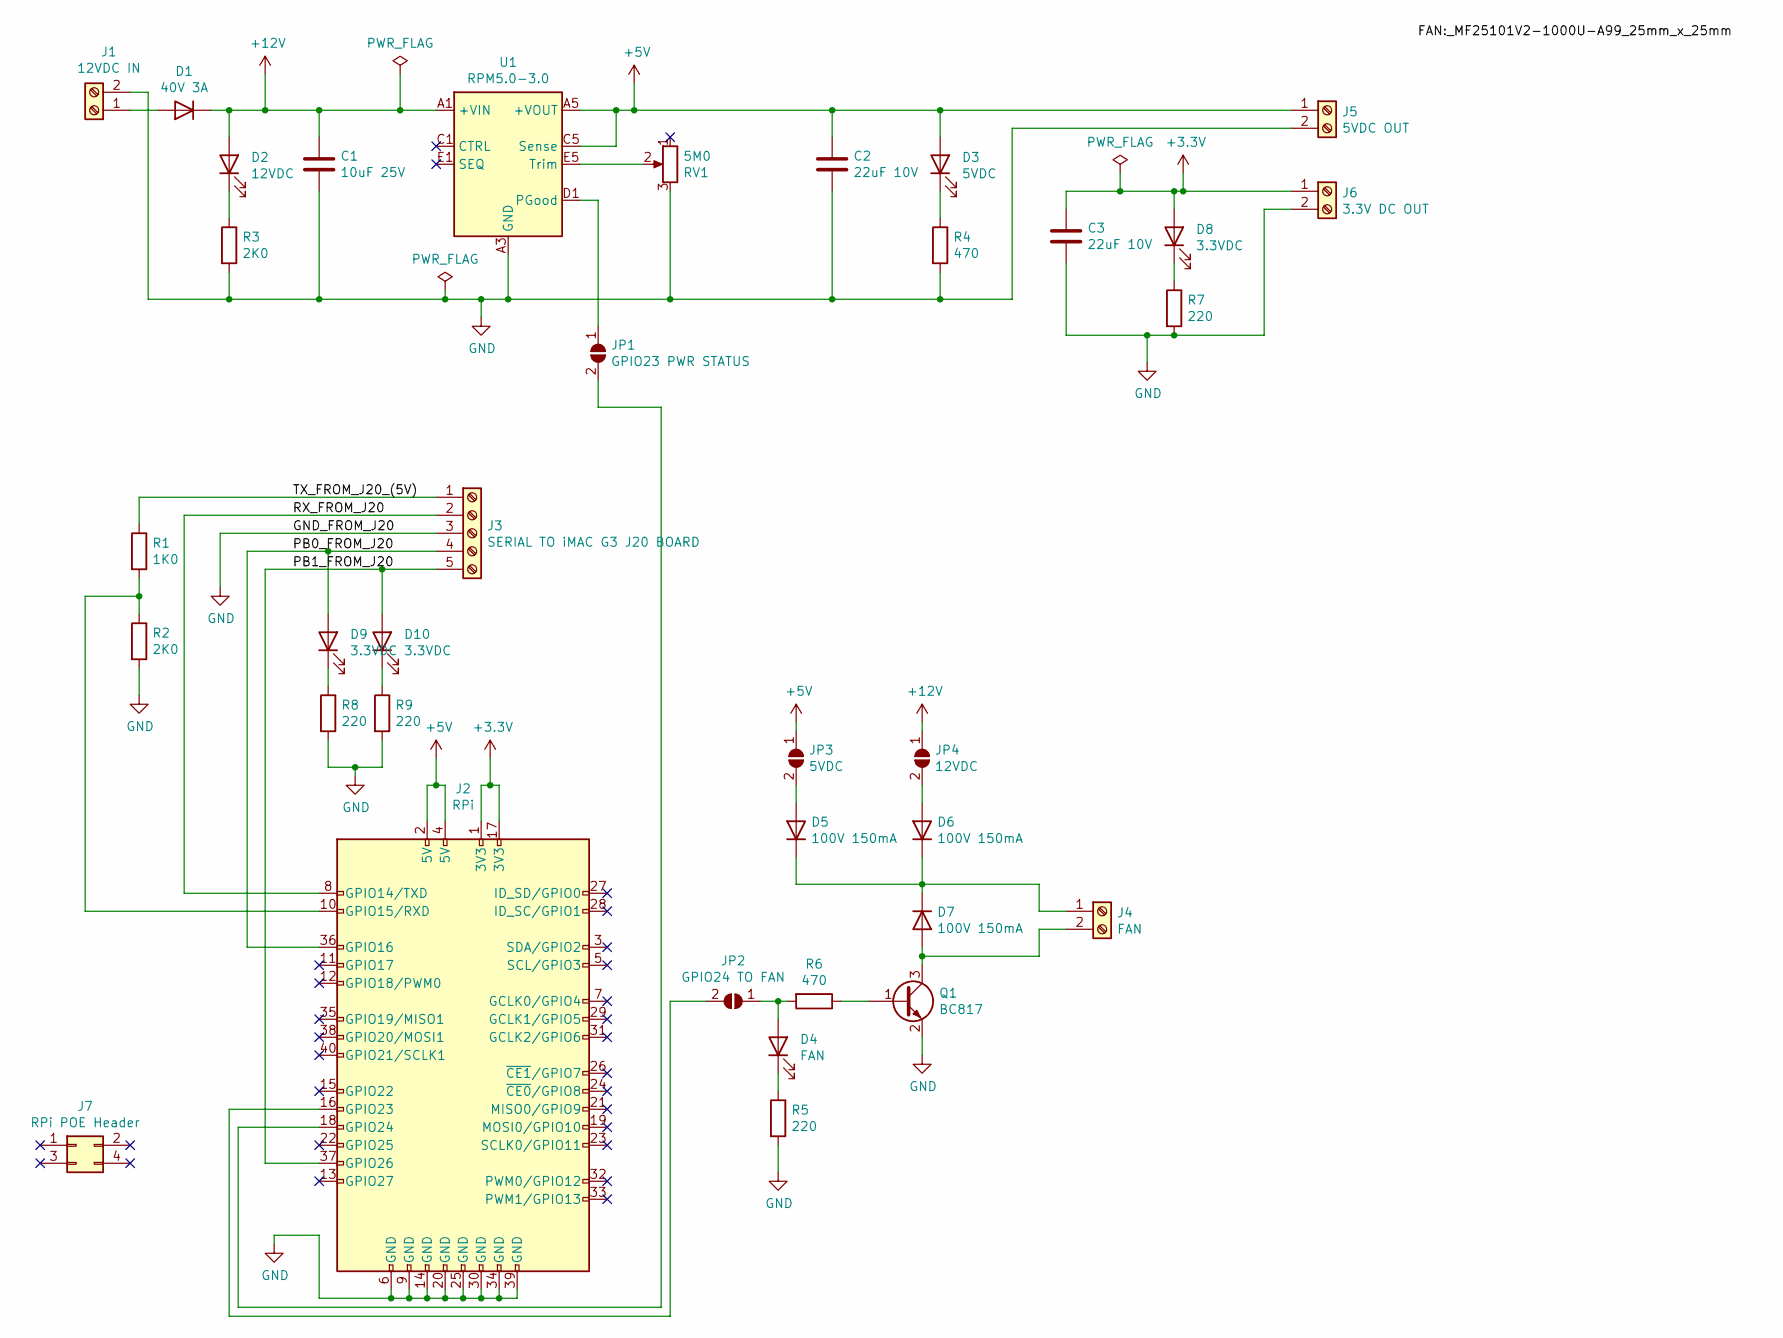
[picture p86: schematic RPiG3iMac.sch, HAT de Raspberry Pi - iMac G3]

Parts:
C1: 10uF 25V; C_0603_1608Metric
C2, C3: 22uF 10V; C_0603_1608Metric
D1: 40V 3A; D_SMB
D2: 12VDC; LED_0603_1608Metric
D3: 5VDC; LED_0603_1608Metric
D4: FAN; LED_0603_1608Metric
D5, D6, D7: 100V 150mA; D_SOD-123
D8, D9, D10: 3.3VDC; LED_0603_1608Metric
J1: 12VDC IN; TerminalBlock_Phoenix_MKDS-1,5-2-5.08_1x02_P5.08mm_Horizont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
J2: RPi; Harwin_M20-7812045_2x20_P2.54mm_Vertical_rpi
J3: SERIAL TO iMAC G3 J20 BOARD; TerminalBlock_Phoenix_MPT-0,5-5-2.54_1x05_P2.54mm_Horizontal
J4: FAN; TerminalBlock_Phoenix_MPT-0,5-2-2.54_1x02_P2.54mm_Horizontal
J5: 5VDC OUT; TerminalBlock_Phoenix_MPT-0,5-2-2.54_1x02_P2.54mm_Horizontal
J6: 3.3V DC OUT; TerminalBlock_Phoenix_MPT-0,5-2-2.54_1x02_P2.54mm_Horizontal
J7: RPi POE Header; PinHeader_2x02_P2.54mm_Vertical
JP1: GPIO23 PWR STATUS; SolderJumper-2_P1.3mm_Open_RoundedPad1.0x1.5mm
JP2: GPIO24 TO FAN; SolderJumper-2_P1.3mm_Open_RoundedPad1.0x1.5mm
JP3: 5VDC; SolderJumper-2_P1.3mm_Open_RoundedPad1.0x1.5mm
JP4: 12VDC; SolderJumper-2_P1.3mm_Open_RoundedPad1.0x1.5mm
Q1: BC817; SOT-23
R1: 1K0; R_0603_1608Metric
R2, R3: 2K0; R_0603_1608Metric
R4, R6: 470; R_0603_1608Metric
R5, R7, R8, R9: 220; R_0603_1608Metric
RV1: 5M0; Potentiometer_Bourns_3296Y_Vertical
U1: RPM5.0-3.0; Converter_DCDC_RECOM_RPMx.x-x.0

Connections:
+3V3: C3.1, D8.2 (A), J2.1 (3V3), J2.17 (3V3), J6.1
+5V: C2.1, D3.2 (A), J2.2 (5V), J2.4 (5V), J5.1, JP3.1 (A), U1.A5 (+VOUT), U1.B5 (+VOUT), U1.C5 (Sense)
+12V: C1.1, D1.1 (K), D2.2 (A), JP4.1 (A), U1.A1 (+VIN), U1.A2 (+VIN)
/PB0_FROM_J20: D9.2 (A), J2.36 (GPIO16), J3.4
/PB1_FROM_J20: D10.2 (A), J2.37 (GPIO26), J3.5
/RX_FROM_J20: J2.8 (GPIO14/TXD), J3.2
/TX_FROM_J20_(5V): J3.1, R1.1
GND: C1.2, C2.2, C3.2, J1.2, J2.6 (GND), J2.9 (GND), J2.14 (GND), J2.20 (GND), J2.25 (GND), J2.30 (GND), J2.34 (GND), J2.39 (GND), J3.3, J5.2, J6.2, Q1.2 (E), R2.2, R3.2, R4.2, R5.2, R7.2, R8.2, R9.2, RV1.3, U1.A3 (GND), U1.A4 (GND), U1.B1 (GND), U1.B2 (GND), U1.B3 (GND), U1.B4 (GND), U1.C2 (GND), U1.C3 (GND), U1.C4 (GND), U1.D2 (GND), U1.D3 (GND), U1.D4 (GND), U1.D5 (GND), U1.E3 (GND), U1.E4 (GND)
unnamed: D1.2 (A), J1.1
unnamed: D2.1 (K), R3.1
unnamed: D3.1 (K), R4.1
unnamed: D4.1 (K), R5.1
unnamed: D4.2 (A), JP2.1 (A), R6.2
unnamed: D5.1 (K), D6.1 (K), D7.1 (K), J4.1
unnamed: D5.2 (A), JP3.2 (B)
unnamed: D6.2 (A), JP4.2 (B)
unnamed: D7.2 (A), J4.2, Q1.3 (C)
unnamed: D8.1 (K), R7.1
unnamed: D9.1 (K), R8.1
unnamed: D10.1 (K), R9.1
unnamed: J2.10 (GPIO15/RXD), R1.2, R2.1
unnamed: J2.16 (GPIO23), JP2.2 (B)
unnamed: J2.18 (GPIO24), JP1.2 (B)
unnamed: JP1.1 (A), U1.D1 (PGood)
unnamed: Q1.1 (B), R6.1
unnamed: RV1.2, U1.E5 (Trim)

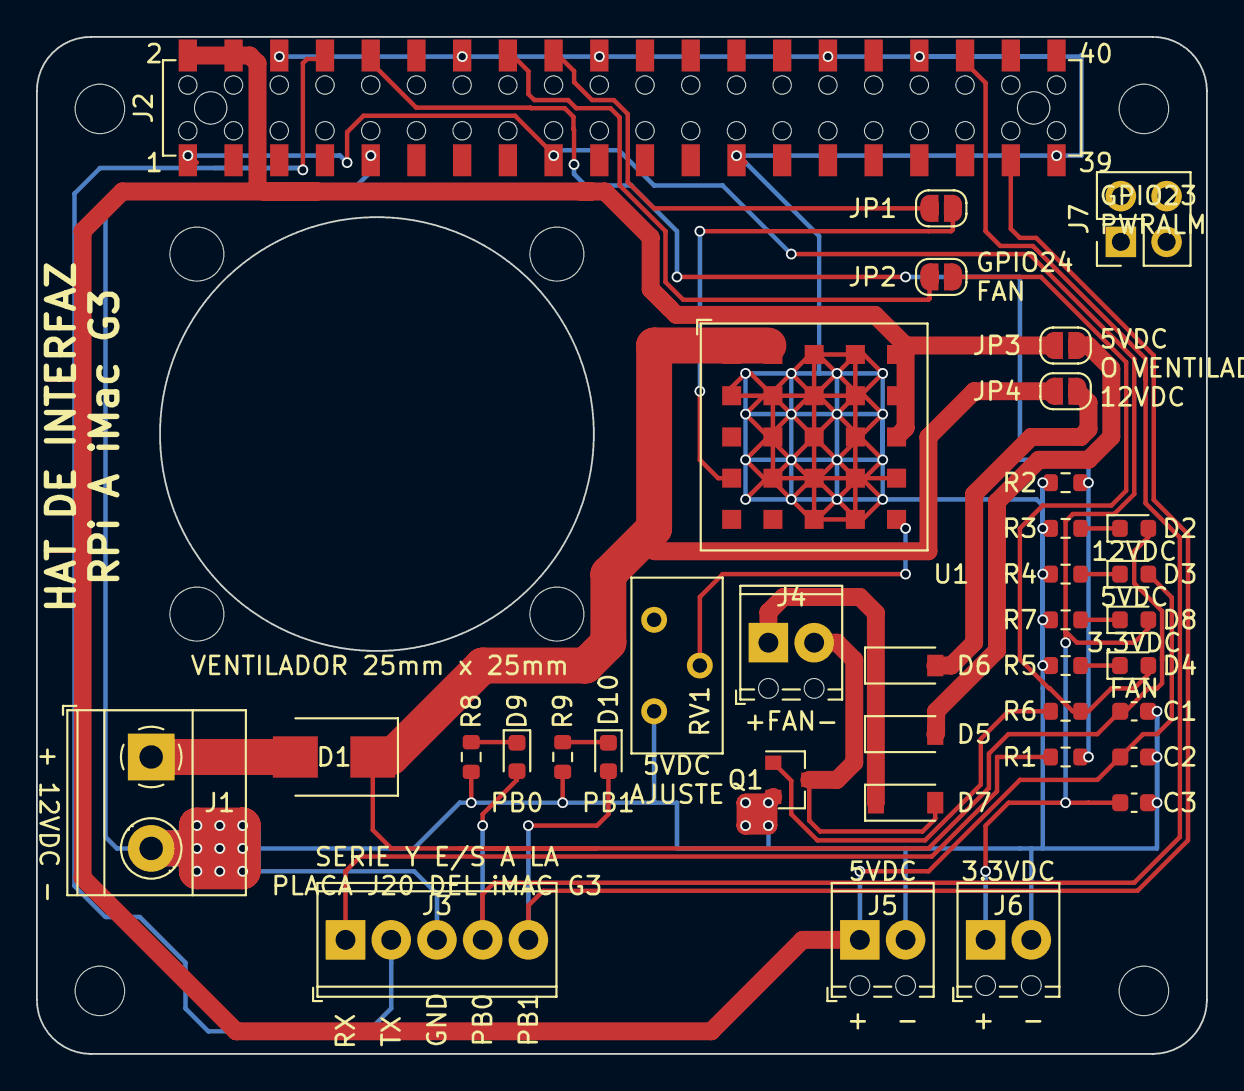
[picture p87: board RPiG3iMac.kicad_pcb from above]

Board: 2 copper layers, 65.0 x 56.5 mm, 40 parts (0 on the bottom side), 26 nets.

Other parts of the board:
 : MountingHole_3mm
 #2,  #3,  #4: MountingHole_3mm
