JJaroll/MacBerry-Pi/hardware/contribuciones_rudy/RPiG3iMacJ20/RPiG3iMacJ20.kicad_pcb

## KiCad design hardware/contribuciones_rudy/RPiG3iMacJ20/RPiG3iMacJ20.kicad_pcb (2026-10-20)

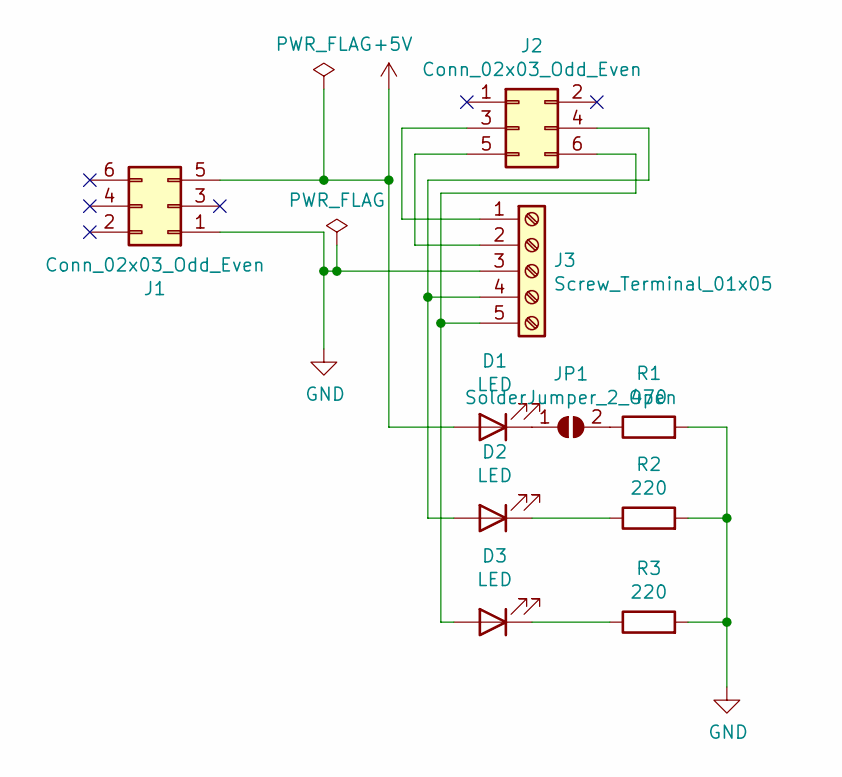
[picture p88: schematic RPiG3iMacJ20.sch, Interfaz HAT de Raspberry Pi - iMac G3 J20]

Parts:
D1, D2, D3: LED; LED_0603_1608Metric
J1, J2: Conn_02x03_Odd_Even; Harwin_M20-7810345_2x03_P2.54mm_Vertical
J3: Screw_Terminal_01x05; TerminalBlock_Phoenix_MPT-0,5-5-2.54_1x05_P2.54mm_Horizontal
JP1: SolderJumper_2_Open; SolderJumper-2_P1.3mm_Open_RoundedPad1.0x1.5mm
R1: 470; R_0603_1608Metric
R2, R3: 220; R_0603_1608Metric

Connections:
+5V: D1.2 (A), J1.5
GND: J1.1, J3.3, R1.2, R2.2, R3.2
unnamed: D1.1 (K), JP1.1 (A)
unnamed: D2.1 (K), R2.1
unnamed: D2.2 (A), J2.4, J3.4
unnamed: D3.1 (K), R3.1
unnamed: D3.2 (A), J2.6, J3.5
unnamed: J2.3, J3.1
unnamed: J2.5, J3.2
unnamed: JP1.2 (B), R1.1

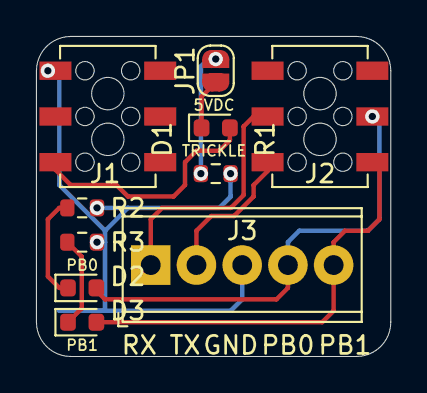
[picture p89: board RPiG3iMacJ20.kicad_pcb from above]

Board: 2 copper layers, 19.7 x 17.8 mm, 10 parts (0 on the bottom side), 10 nets.
