JJaroll/MacBerry-Pi/originales/surfacemount_version/imac_g3_333mhz_slot_loading_J20_adapter_board/imac_g3_333mhz_slot_loading_J20_adapter_board.kicad_pcb

## KiCad design originales/surfacemount_version/imac_g3_333mhz_slot_loading_J20_adapter_board/imac_g3_333mhz_slot_loading_J20_adapter_board.kicad_pcb (2026-10-20)

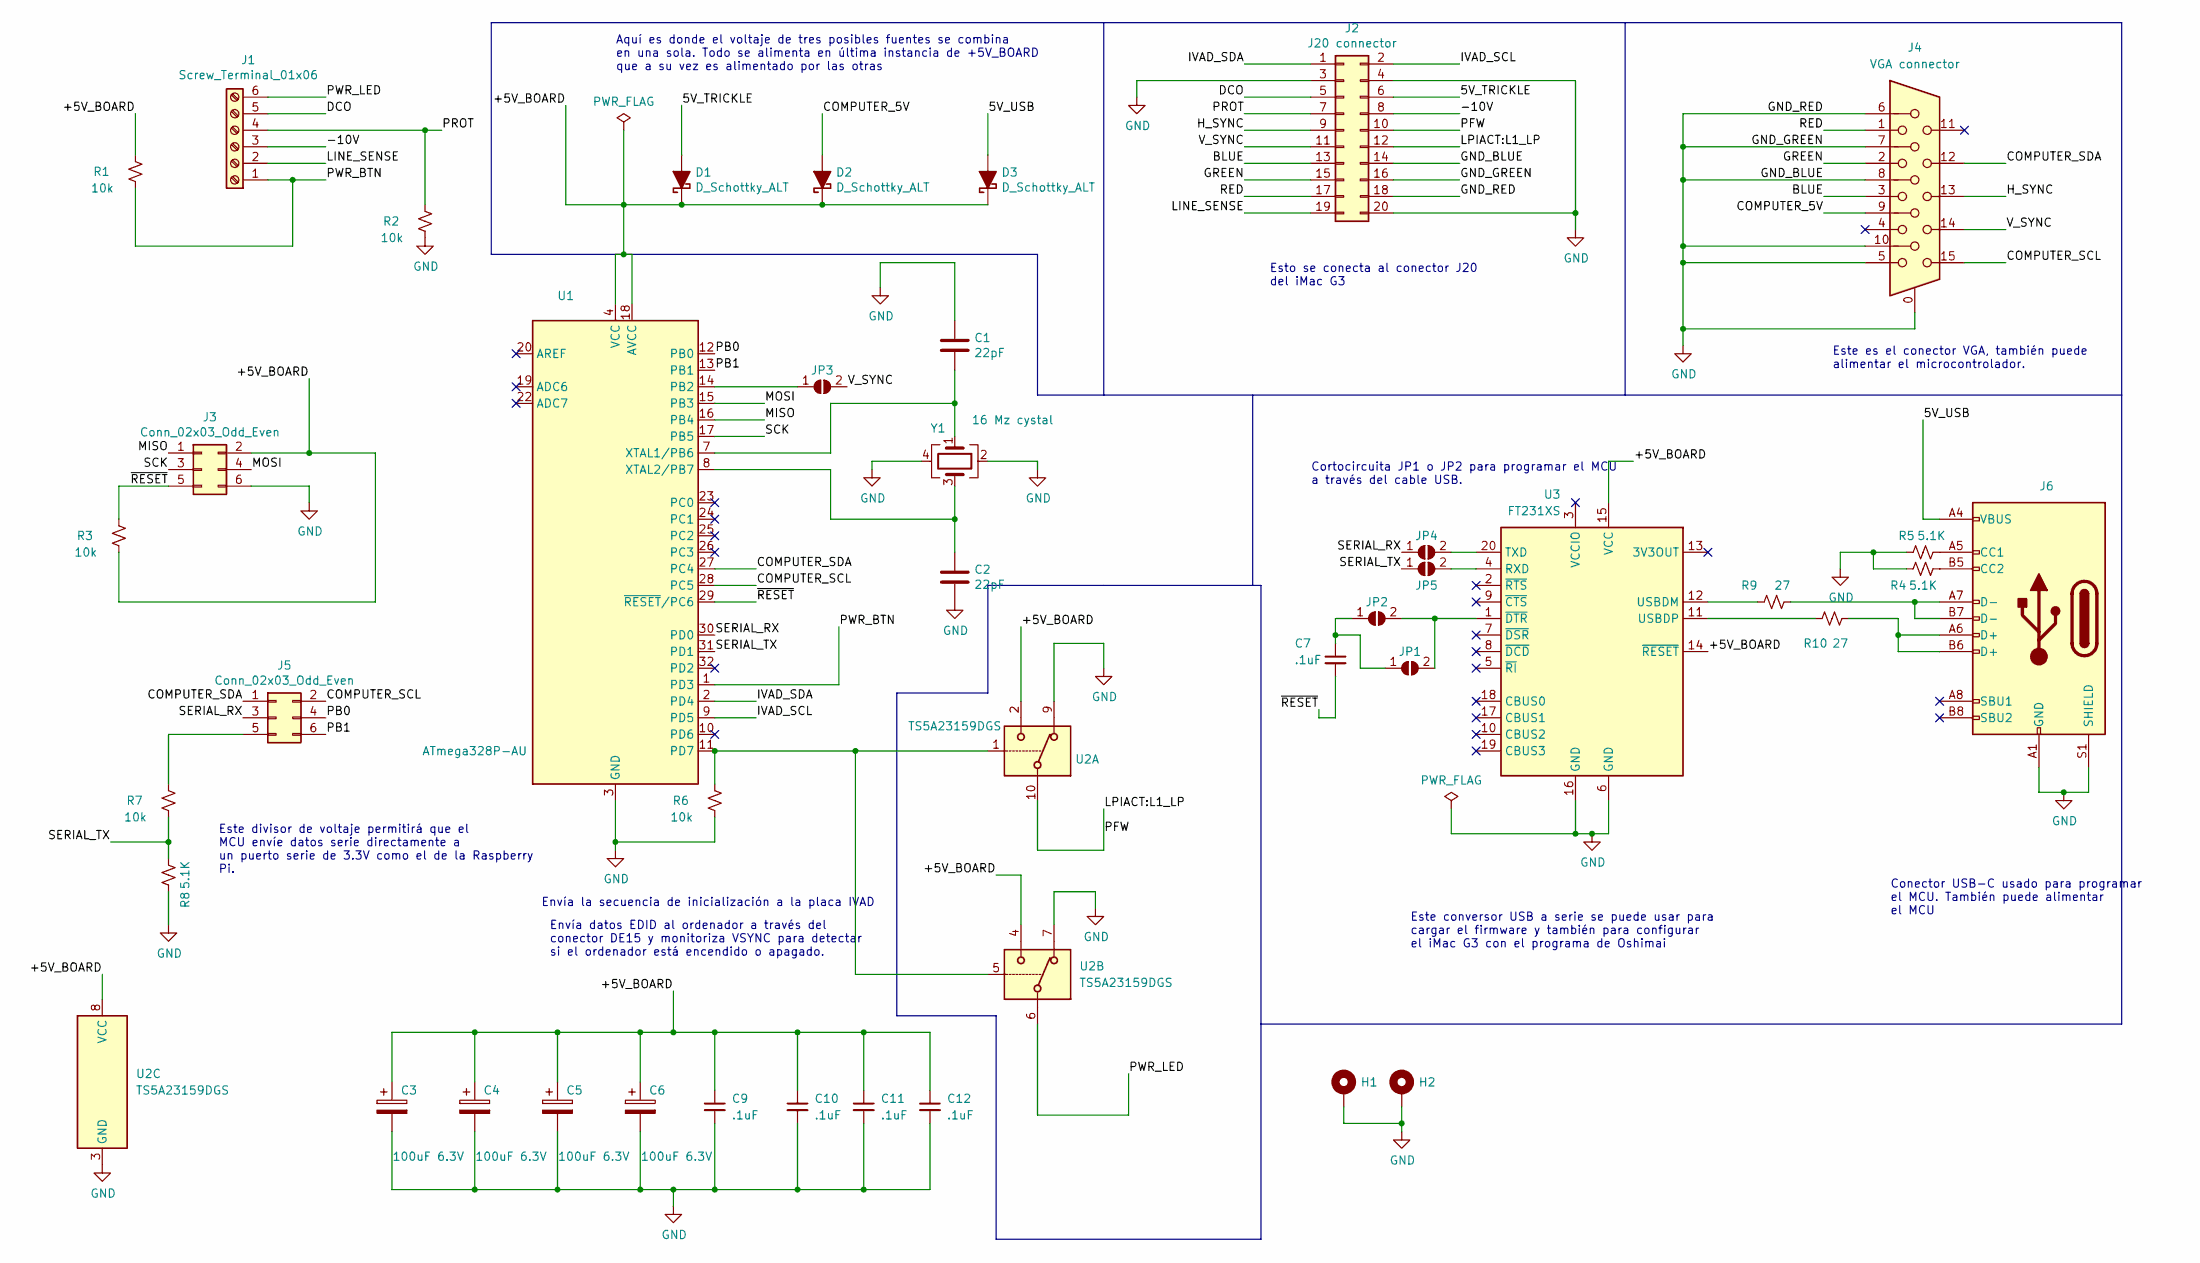
[picture p90: schematic imac_g3_333mhz_slot_loading_J20_adapter_board.kicad_sch, Placa de alimentación y video SMD para iMac G3 333 Mhz Slot…]

Parts:
C1, C2: 22pF; C_0805_2012Metric_Pad1.18x1.45mm_HandSolder; Manufacturer part# CL21C220JBANNNC
C3, C4, C5, C6: 100uF 6.3V; CP_EIA-3528-21_Kemet-B_Pad1.50x2.35mm_HandSolder; Manufacturer part# TAJB107K006RNJ
C7, C9, C10, C11, C12: .1uF; C_0805_2012Metric_Pad1.18x1.45mm_HandSolder; Manufacturer part# CL21B104KCFNNNE
D1, D2, D3: D_Schottky_ALT; D_SOD-123; Manufacturer part# B5819W SL
H1, H2: MountingHole_Pad; MountingHole_3.5mm_Pad
J1: Screw_Terminal_01x06; TerminalBlock_Phoenix_PT-1,5-6-5.0-H_1x06_P5.00mm_Horizontal; Part# 277-1581-ND
J2: J20 connector; PinHeader_2x10_P2.54mm_Vertical; Part# SAM1068-10-ND
J3: Conn_02x03_Odd_Even; PinHeader_2x03_P2.54mm_Vertical; Part# 732-5394-ND
J4: VGA connector; DSUB-15-HD_Female_Horizontal_P2.29x1.98mm_EdgePinOffset8.35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; Manufacturer part# Z-SUBHRBF707A000
J5: Conn_02x03_Odd_Even; PinHeader_2x03_P2.54mm_Vertical; Part# 609-3234-ND
J6: USB_C_Receptacle_USB2.0; USB_C_Receptacle_G-Switch_GT-USB-7010ASV; Manufacturer part# TYPE C-DB-108PWB
JP1: SolderJumper_2_Open; PinHeader_1x02_P2.54mm_Vertical
JP2, JP3, JP4, JP5: SolderJumper_2_Open; SolderJumper-2_P1.3mm_Open_RoundedPad1.0x1.5mm
R1, R2, R3, R6, R7: 10k; R_0805_2012Metric_Pad1.20x1.40mm_HandSolder; Manufacturer part# 0805W8F1002T5E
R4, R5, R8: 5.1K; R_0805_2012Metric_Pad1.20x1.40mm_HandSolder; Manufacturer part# 0805W8F5101T5E
R9, R10: 27; R_0805_2012Metric_Pad1.20x1.40mm_HandSolder; Manufacturer part# 0805W8F270JT5E
U1: ATmega328P-AU; TQFP-32_7x7mm_P0.8mm; Manufacturer part# ATMEGA328P-AU
U2: TS5A23159DGS; VSSOP-10_3x3mm_P0.5mm; Manufacturer part# TS5A23159DGSR
U3: FT231XS; SSOP-20_3.9x8.7mm_P0.635mm; Manufacturer part# FT231XS-R
Y1: 16 Mz cystal; Crystal_SMD_3225-4Pin_3.2x2.5mm_HandSoldering; Manufacturer part# X322516MLB4SI

Connections:
/5V_TRICKLE: D1.2 (A), J2.6
/5V_USB: D3.2 (A), J6.A4 (VBUS), J6.A9 (VBUS), J6.B4 (VBUS), J6.B9 (VBUS)
/+5V_BOARD: C3.1, C4.1, C5.1, C6.1, C9.1, C10.1, C11.1, C12.1, D1.1 (K), D2.1 (K), D3.1 (K), J3.2, R1.2, R3.1, U1.4 (VCC), U1.6 (VCC), U1.18 (AVCC), U2.2, U2.4, U2.8 (VCC), U3.14 (~RESET), U3.15 (VCC)
/-10V: J1.3, J2.8
/BLUE: J2.13, J4.3
/COMPUTER_5V: D2.2 (A), J4.9
/COMPUTER_SCL: J4.15, J5.2, U1.28 (PC5)
/COMPUTER_SDA: J4.12, J5.1, U1.27 (PC4)
/DCO: J1.5, J2.5
/GREEN: J2.15, J4.2
/H_SYNC: J2.9, J4.13
/IVAD_SCL: J2.2, U1.9 (PD5)
/IVAD_SDA: J2.1, U1.2 (PD4)
/LINE_SENSE: J1.2, J2.19
/LPIACT:L1_LP: J2.10, J2.12, U2.10
/MISO: J3.1, U1.16 (PB4)
/MOSI: J3.4, U1.15 (PB3)
/PB0: J5.4, U1.12 (PB0)
/PB1: J5.6, U1.13 (PB1)
/PROT: J1.4, J2.7, R2.2
/PWR_BTN: J1.1, R1.1, U1.1 (PD3)
/PWR_LED: J1.6, U2.6
/RED: J2.17, J4.1
/SCK: J3.3, U1.17 (PB5)
/SERIAL_RX: J5.3, JP4.1 (A), U1.30 (PD0)
/SERIAL_TX: JP5.1 (A), R7.1, R8.1, U1.31 (PD1)
/V_SYNC: J2.11, J4.14, JP3.2 (B)
/~RESET: C7.2, J3.5, R3.2, U1.29 (~RESET/PC6)
GND: C1.1, C2.2, C3.2, C4.2, C5.2, C6.2, C9.2, C10.2, C11.2, C12.2, H1.1, H2.1, J2.3, J2.4, J2.14, J2.16, J2.18, J2.20, J3.6, J4.0, J4.5, J4.6, J4.7, J4.8, J4.10, J6.A1 (GND), J6.A12 (GND), J6.B1 (GND), J6.B12 (GND), J6.S1 (SHIELD), R2.1, R4.2, R5.2, R6.1, R8.2, U1.3 (GND), U1.5 (GND), U1.21 (GND), U2.3 (GND), U2.7, U2.9, U3.6 (GND), U3.16 (GND), Y1.2, Y1.4
unnamed: J5.5, R7.2
unnamed: J6.A5 (CC1), R5.1
unnamed: J6.B5 (CC2), R4.1
unnamed: J6.A6 (D+), J6.B6 (D+), R10.1
unnamed: J6.A7 (D-), J6.B7 (D-), R9.1
unnamed: C7.1, JP1.1 (A), JP2.1 (A)
unnamed: JP1.2 (B), JP2.2 (B), U3.1 (~DTR)
unnamed: JP3.1 (A), U1.14 (PB2)
unnamed: JP4.2 (B), U3.20 (TXD)
unnamed: JP5.2 (B), U3.4 (RXD)
unnamed: R6.2, U1.11 (PD7), U2.1, U2.5
unnamed: C1.2, U1.7 (XTAL1/PB6), Y1.1
unnamed: C2.1, U1.8 (XTAL2/PB7), Y1.3
unnamed: R9.2, U3.12 (USBDM)
unnamed: R10.2, U3.11 (USBDP)

Notes on the sheet:
Conector USB-C usado para programar el MCU. También puede alimentar el MCU
Este es el conector VGA, también puede alimentar el microcontrolador.
Aquí es donde el voltaje de tres posibles fuentes se combina en una sola. Todo se alimenta en última instancia de +5V_BOARD que a su vez es alimentado por las otras
Envía datos EDID al ordenador a través del conector DE15 y monitoriza VSYNC para detectar si el ordenador está encendido o apagado.
Esto se conecta al conector J20 del iMac G3
Este conversor USB a serie se puede usar para cargar el firmware y también para configurar el iMac G3 con el programa de Oshimai
Cortocircuita JP1 o JP2 para programar el MCU a través del cable USB.
Este divisor de voltaje permitirá que el MCU envíe datos serie directamente a un puerto serie de 3.3V como el de la Raspberry Pi.
Envía la secuencia de inicialización a la placa IVAD

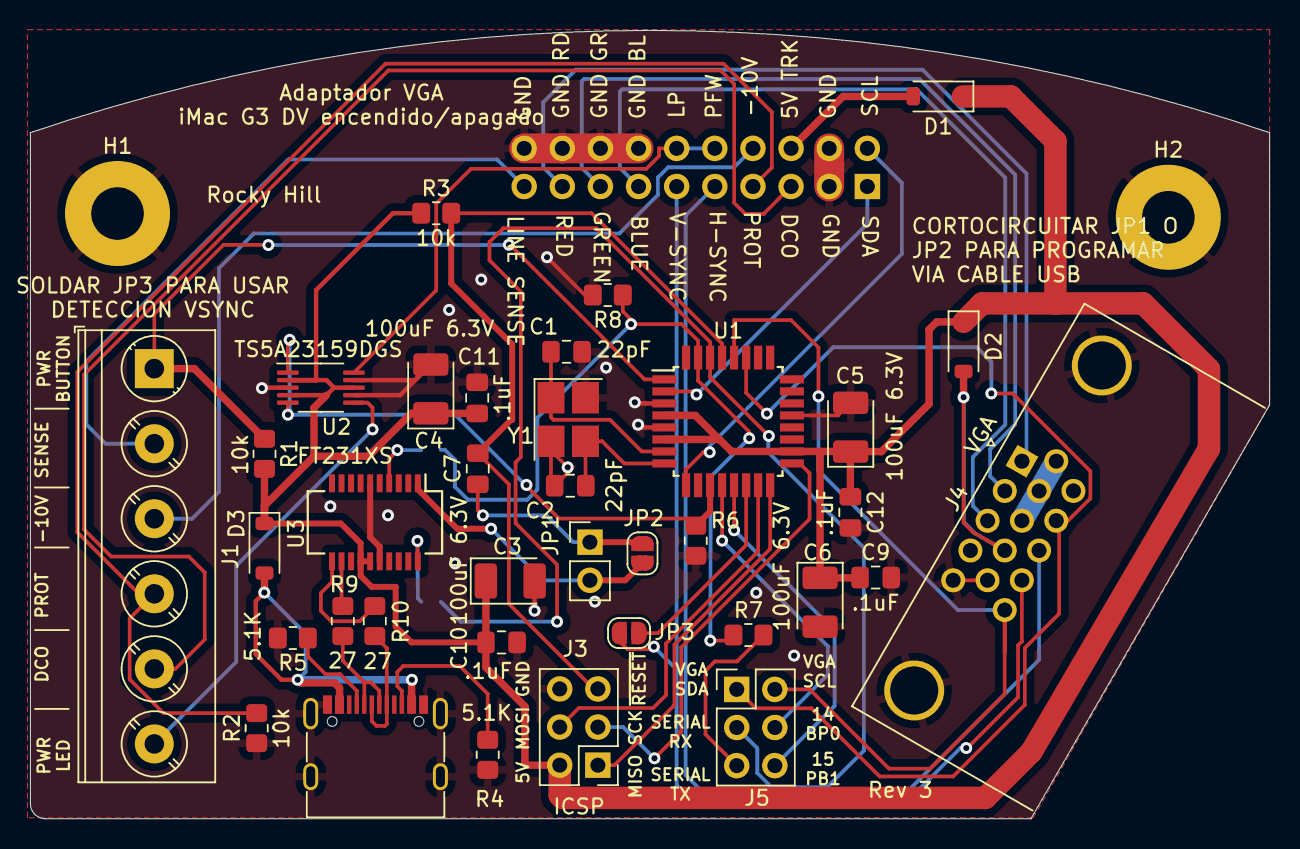
[picture p91: board originales/surfacemount_version/imac_g3_333mhz_slot_loading_J20_adapt… from above]

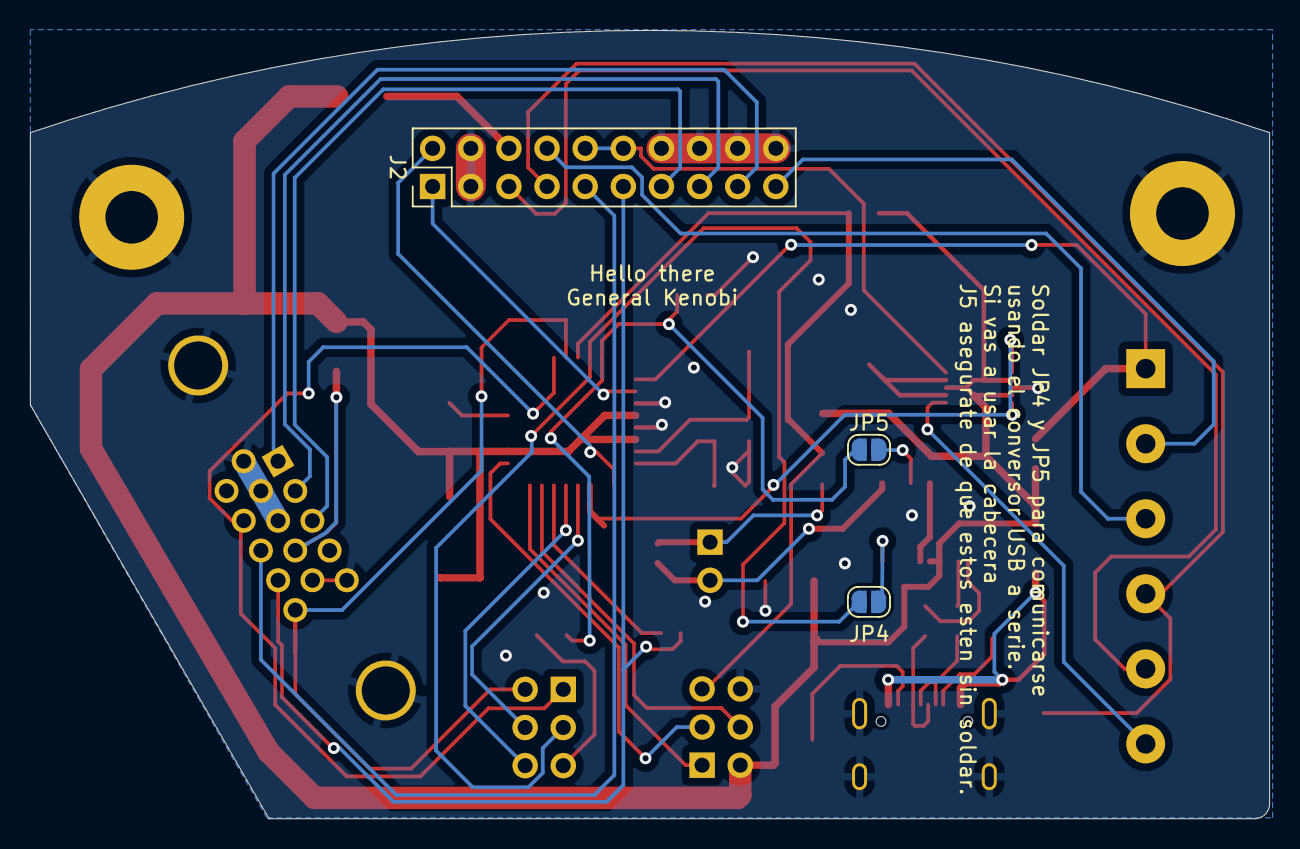
[picture p92: board originales/surfacemount_version/imac_g3_333mhz_slot_loading_J20_adapt… from below]

Board: 2 copper layers, 82.5 x 52.5 mm, 41 parts (3 on the bottom side), 44 nets.
