JJaroll/MacBerry-Pi/originales/proyecto_kicad_original/imac_g3_333mhz_slot_loading_J20_adapter_board/imac_g3_333mhz_slot_loading_J20_adapter_board.kicad_pcb

## KiCad design originales/proyecto_kicad_original/imac_g3_333mhz_slot_loading_J20_adapter_board/imac_g3_333mhz_slot_loading_J20_adapter_board.kicad_pcb (2026-10-20)

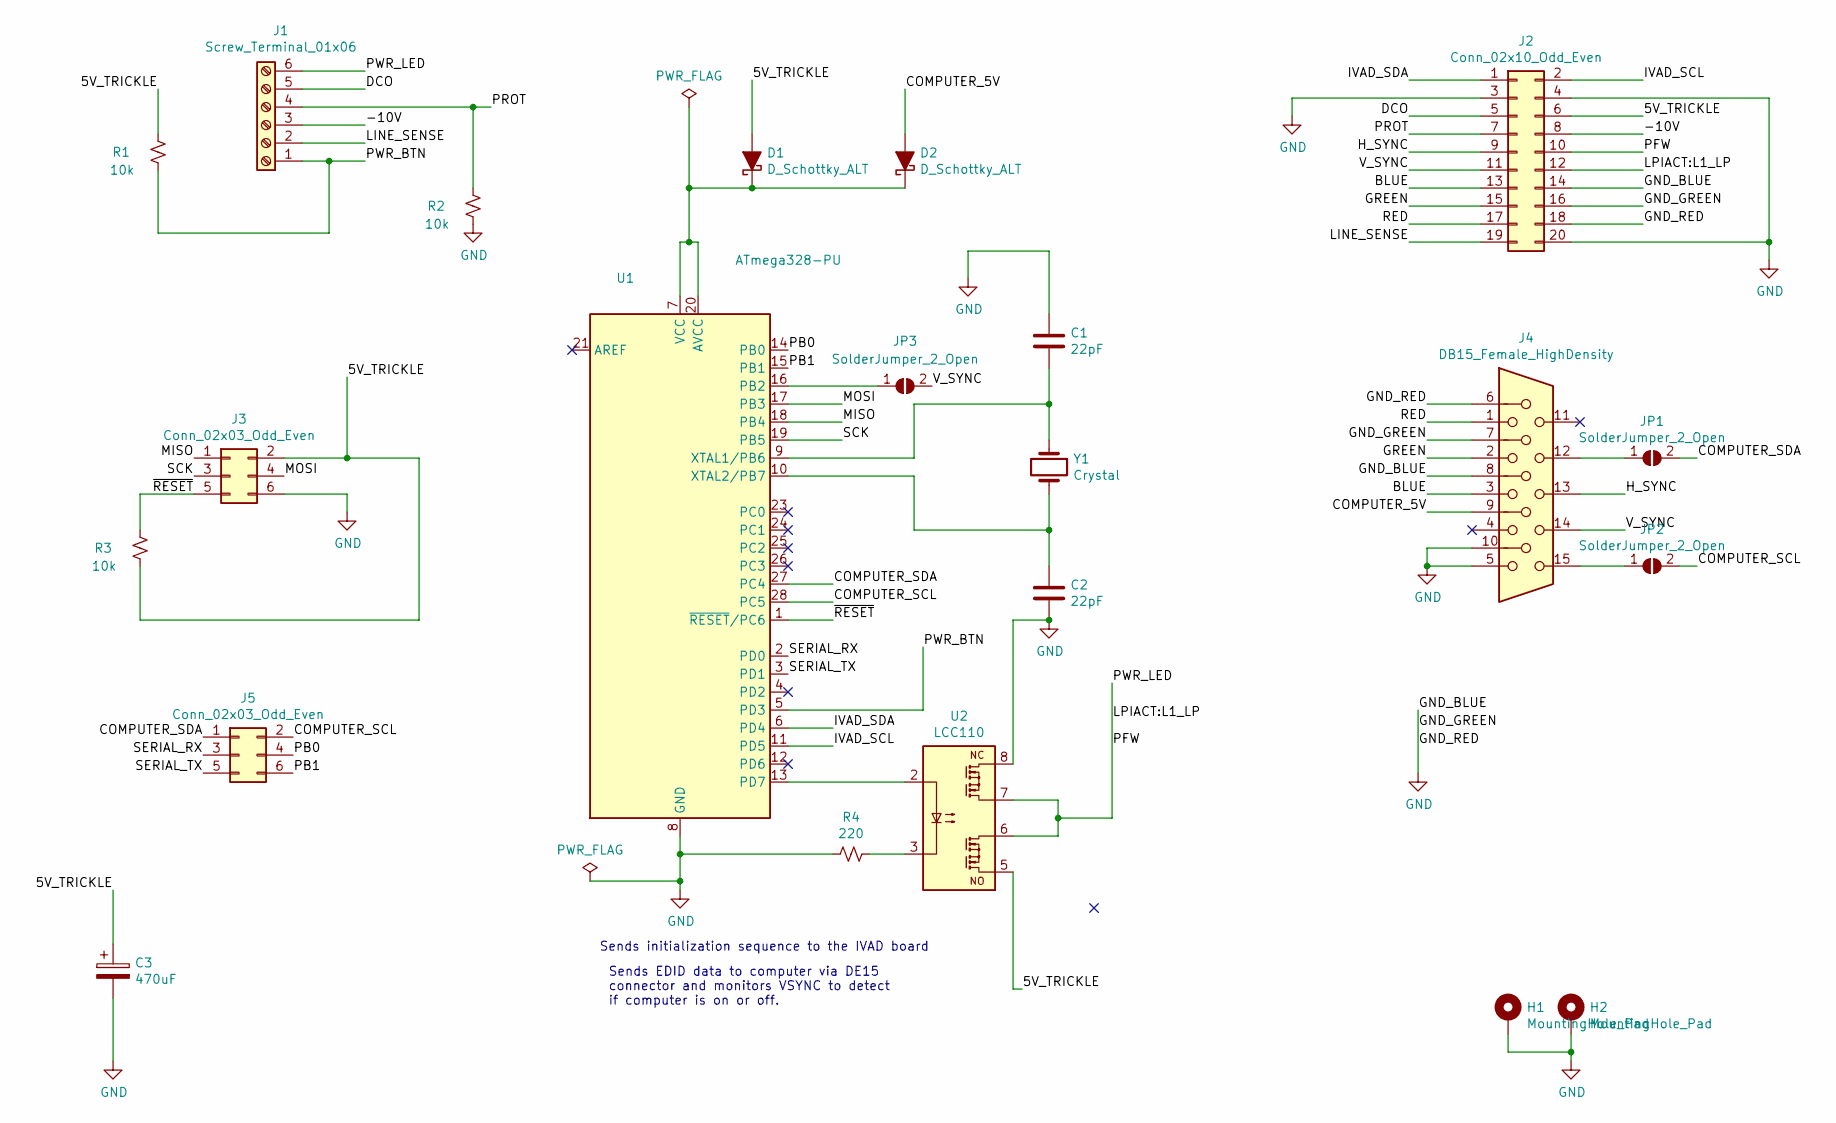
[picture p98: schematic imac_g3_333mhz_slot_loading_J20_adapter_board.sch, iMac G3 333 Mhz Slot Loading Power and Video Board]

Parts:
C1, C2: 22pF; C_Disc_D5.0mm_W2.5mm_P5.00mm; Part# 445-15973-ND
C3: 470uF; CP_Radial_D8.0mm_P3.50mm; Part# 493-1702-ND
D1, D2: D_Schottky_ALT; D_DO-41_SOD81_P7.62mm_Horizontal; Part# 1N5819-E3/54GICT-ND
H1, H2: MountingHole_Pad; MountingHole_3.5mm_Pad
J1: Screw_Terminal_01x06; TerminalBlock_Phoenix_PT-1,5-6-5.0-H_1x06_P5.00mm_Horizontal; Part# 277-1581-ND
J2: Conn_02x10_Odd_Even; PinHeader_2x10_P2.54mm_Vertical; Part# SAM1068-10-ND
J3: Conn_02x03_Odd_Even; PinHeader_2x03_P2.54mm_Vertical; Part# 732-5394-ND
J4: DB15_Female_HighDensity; DSUB-15-HD_Female_Horizontal_P2.29x1.98mm_EdgePinOffset8.35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; Part# L77HDE15SD1CH4F-ND
J5: Conn_02x03_Odd_Even; PinHeader_2x03_P2.54mm_Vertical; Part# 609-3234-ND
JP1, JP2, JP3: SolderJumper_2_Open; SolderJumper-2_P1.3mm_Open_RoundedPad1.0x1.5mm
R1, R2, R3: 10k; R_Axial_DIN0207_L6.3mm_D2.5mm_P7.62mm_Horizontal; Part# CF14JT10K0CT-ND
R4: 220; R_Axial_DIN0207_L6.3mm_D2.5mm_P7.62mm_Horizontal; Part# CF14JT220RCT-ND
U1: ATmega328-PU; DIP-28_W7.62mm; Part# ATMEGA328P-PU-ND
U2: LCC110; DIP-8_W7.62mm; Part# CLA106-ND
Y1: Crystal; Crystal_HC49-U_Vertical; Part# 887-2015-ND

Connections:
/5V_TRICKLE: C3.1, D1.2 (A), J2.6, J3.2, R1.2, R3.1, U2.5
/-10V: J1.3, J2.8
/BLUE: J2.13, J4.3
/COMPUTER_5V: D2.2 (A), J4.9
/COMPUTER_SCL: J5.2, JP2.2 (B), U1.28 (PC5)
/COMPUTER_SDA: J5.1, JP1.2 (B), U1.27 (PC4)
/DCO: J1.5, J2.5
/GREEN: J2.15, J4.2
/H_SYNC: J2.9, J4.13
/IVAD_SCL: J2.2, U1.11 (PD5)
/IVAD_SDA: J2.1, U1.6 (PD4)
/LINE_SENSE: J1.2, J2.19
/LPIACT:L1_LP: J1.6, J2.10, J2.12, U2.6, U2.7
/MISO: J3.1, U1.18 (PB4)
/MOSI: J3.4, U1.17 (PB3)
/PB0: J5.4, U1.14 (PB0)
/PB1: J5.6, U1.15 (PB1)
/PROT: J1.4, J2.7, R2.2
/PWR_BTN: J1.1, R1.1, U1.5 (PD3)
/RED: J2.17, J4.1
/SCK: J3.3, U1.19 (PB5)
/SERIAL_RX: J5.3, U1.2 (PD0)
/SERIAL_TX: J5.5, U1.3 (PD1)
/V_SYNC: J2.11, J4.14, JP3.2 (B)
/~RESET: J3.5, R3.2, U1.1 (~RESET~/PC6)
GND: C1.1, C2.2, C3.2, H1.1, H2.1, J2.3, J2.4, J2.14, J2.16, J2.18, J2.20, J3.6, J4.5, J4.6, J4.7, J4.8, J4.10, R2.1, R4.1, U1.8 (GND), U1.22 (GND), U2.8
unnamed: C1.2, U1.9 (XTAL1/PB6), Y1.1
unnamed: C2.1, U1.10 (XTAL2/PB7), Y1.2
unnamed: D1.1 (K), D2.1 (K), U1.7 (VCC), U1.20 (AVCC)
unnamed: J4.12, JP1.1 (A)
unnamed: J4.15, JP2.1 (A)
unnamed: JP3.1 (A), U1.16 (PB2)
unnamed: R4.2, U2.3
unnamed: U1.13 (PD7), U2.2

Notes on the sheet:
Sends initialization sequence to the IVAD board
Sends EDID data to computer via DE15 connector and monitors VSYNC to detect if computer is on or off.

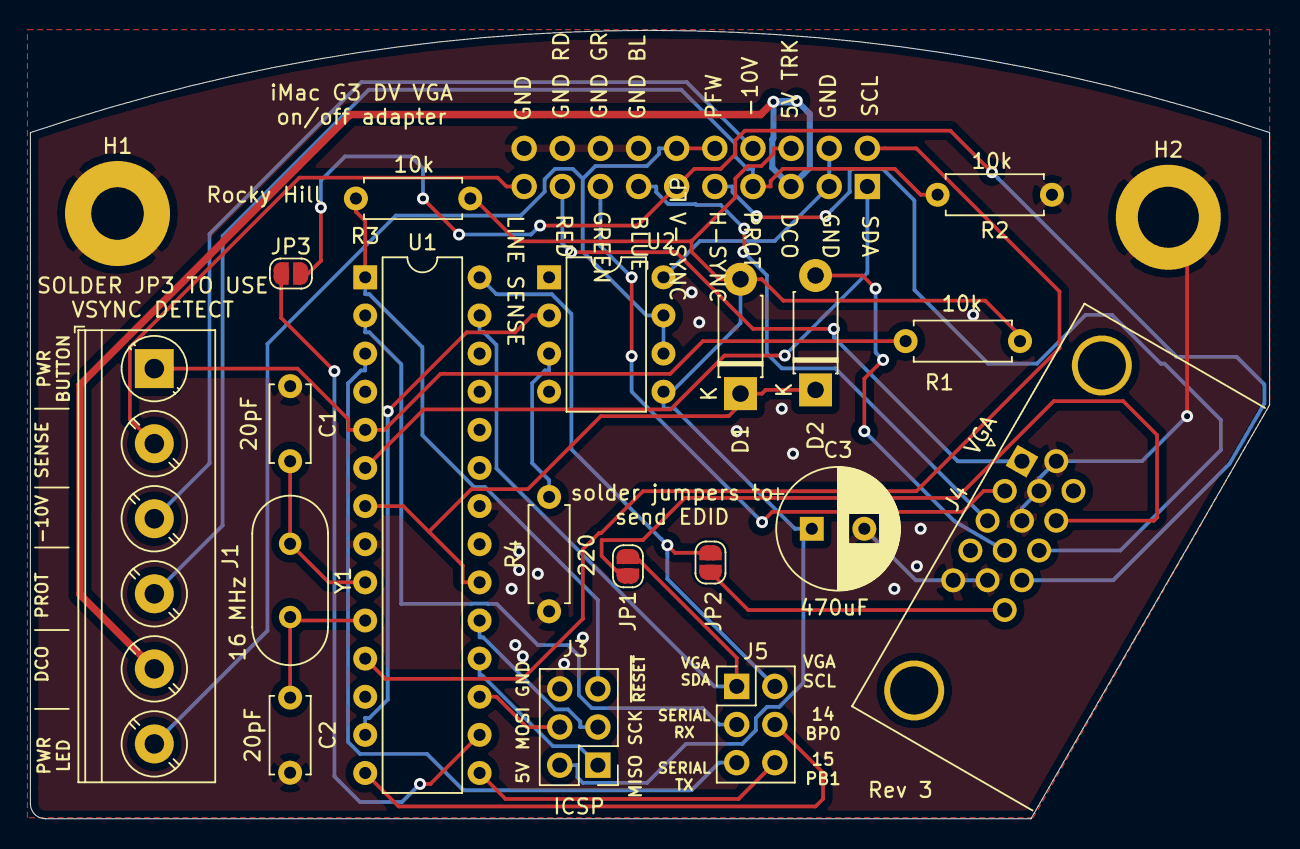
[picture p99: board originales/proyecto_kicad_original/imac_g3_333mhz_slot_loading_J20_ad… from above]

Board: 2 copper layers, 82.5 x 52.5 mm, 22 parts (1 on the bottom side), 34 nets.
