JJaroll/MacBerry-Pi/hardware/master_pcb/PCB_imac_unificado_master_v5_con_corte.kicad_pcb

## KiCad design hardware/master_pcb/PCB_imac_unificado_master_v5_con_corte.kicad_pcb (2026-10-20)

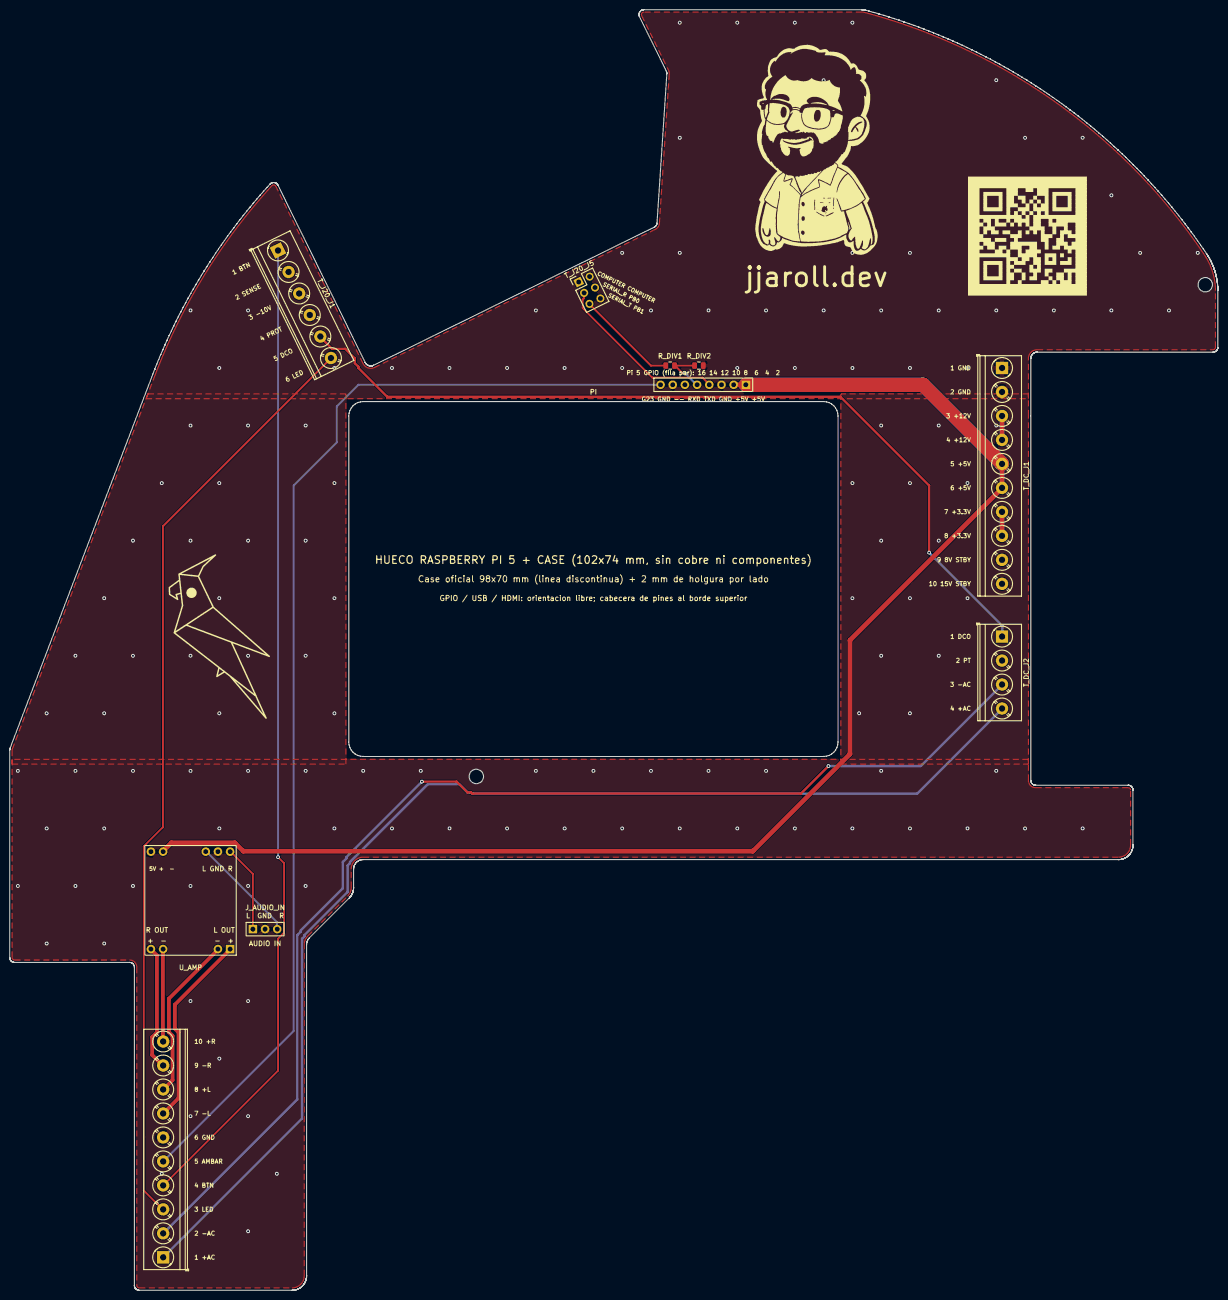
[picture p100: board PCB_imac_unificado_master_v5_con_corte.kicad_pcb from above]

Board: 2 copper layers, 251.9 x 267.0 mm, 17 parts (0 on the bottom side), 19 nets.

Parts:
H_BASE_A: Tornillo a la base M3; MountingHole_3.0mm
H_BASE_B: Tornillo a la base M3; MountingHole_3.0mm
J_AUDIO_IN: Entrada audio L/GND/R; AudioIn_1x03_P2.54
J_PI_GPIO: GPIO Pi 5 pines 2-16 (fila par); Pi_GPIO_EvenRow_1x08_P2.54
LOGO_AVATAR: LOGO_AVATAR
LOGO_LORO: LOGO_LORO
LOGO_QR: LOGO_QR
LOGO_TEXTO: LOGO_TEXTO
PI: Hueco Raspberry Pi 5 con case (102x74); RaspberryPi5_Case_Hueco
R_DIV1: 1k; R_0805_2012Metric
R_DIV2: 2k; R_0805_2012Metric
T_DC_J1: Screw_Terminal_01x10; TerminalBlock_Phoenix_PT-1,5-10-5.0-H_1x10_P5.00mm_Horizont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
T_DC_J2: Screw_Terminal_01x04; TerminalBlock_Phoenix_PT-1,5-4-5.0-H_1x04_P5.00mm_Horizontal
T_J20_J1: Screw_Terminal_01x06; TerminalBlock_Phoenix_PT-1,5-6-5.0-H_1x06_P5.00mm_Horizontal
T_J20_J5: Conn_02x03_Odd_Even; PinHeader_2x03_P2.54mm_Vertical
T_J22_J2: Screw_Terminal_01x10; TerminalBlock_Phoenix_PT-1,5-10-5.0-H_1x10_P5.00mm_Horizont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
U_AMP: PAM8403 (modulo 19.05x22.86 mm, pines 2.54); PAM8403_Module_PinPads

Connections:
/+3.3V: T_DC_J1.7, T_DC_J1.8
/+5V: J_PI_GPIO.2, J_PI_GPIO.4, T_DC_J1.5, T_DC_J1.6, U_AMP.8
/+12V: T_DC_J1.3, T_DC_J1.4
/+AC: T_DC_J2.4, T_J22_J2.1
/+LEFT_SPEAKER: T_J22_J2.8, U_AMP.2
/+RIGHT_SPEAKER: T_J22_J2.10, U_AMP.3
/-AC: T_DC_J2.3, T_J22_J2.2
/-LEFT_SPEAKER: T_J22_J2.7, U_AMP.1
/-RIGHT_SPEAKER: T_J22_J2.9, U_AMP.4
/AUDIO_L: J_AUDIO_IN.1, U_AMP.5
/AUDIO_R: J_AUDIO_IN.3, U_AMP.7
/DCO: T_DC_J2.1, T_J20_J1.5
/LPIACT:L1_LP: T_J20_J1.6, T_J22_J2.3
/PI_GPIO23_AMBER: J_PI_GPIO.16, T_J22_J2.5
/PI_RXD: J_PI_GPIO.10, R_DIV1.2, R_DIV2.1
/POWER_BUTTON: T_J20_J1.1, T_J22_J2.4
/SERIAL_RX: J_PI_GPIO.8, T_J20_J5.3
/SERIAL_TX: R_DIV1.1, T_J20_J5.5
GND: J_AUDIO_IN.2, J_PI_GPIO.6, J_PI_GPIO.14, R_DIV2.2, T_DC_J1.1, T_DC_J1.2, T_J22_J2.6, U_AMP.6, U_AMP.9
