JJaroll/MacBerry-Pi/(commit log)

2026-08-27 Traducción de documentación al español y creación de la Guía MacBerry Pi
2026-10-20 MacBerry Pi G3 en español: reestructura completa del repositorio
    Reemplaza el contenido del repositorio por la versión reorganizada:
    - README y guías en español (guía de implementación y cableado Pi 5), créditos y licencias
    - PCB master v5 (KiCad, DRC, QR al repositorio) con biblioteca de huellas JJaroll
    - Placas individuales J20, J22 y Down Converter con serigrafía en español y firma
    - Visores HTML: 3D de todo, cableado sin y con master, visor STL
    - STL: PCB, soporte de la Pi (Rudy) y bisel interior (Anthony Bernaert, CC BY-NC 4.0)
    - Firmware, utilidades y contribuciones de Rudy
    - Material original de qbancoffee (LGPL-3.0) sin modificar en originales/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
    [430452400.stp, Bottom_Left.stl, Bottom_Left_Supported.stl, Bottom_Right.stl, Bottom_Right_Supported.stl, CUI_DEVICES_SJ1-3533NG.step, Dowel_Bottom.stl, Dowel_Left.stl]
2026-10-20 Visor STL del inner bezel (HTML autónomo con los 17 STL embebidos)
    Claude-Session: https://claude.ai/code/session_01CUq9b9AsuT1a2cpCUYrCH3
2026-10-20 README: el visor STL principal es el del inner bezel; el visor de placas se conserva sin listarlo
    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
2026-10-20 Master: biblioteca JJaroll con huellas normalizadas (DRC 7 avisos de biblioteca)
    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
    [PCB_imac_unificado_master_v5_con_corte.kicad_pcb]
2026-10-20 Master v5: Gerbers y taladros regenerados, placa guardada con zonas rellenas, DRC 0 violaciones, vistas previas nuevas
    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
    [PCB_imac_unificado_master_v5_con_corte.kicad_pcb]
2026-10-20 Quitar la variante sin corte del master (.kicad_pcb) y su referencia a Lucide
    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
    [PCB_imac_unificado_master_v5.kicad_pcb]
2026-10-20 Visor STL de placas sin la variante sin corte; se elimina master_v5_sin_corte.stl
    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
    [master_v5_sin_corte.stl]
2026-10-20 iBOM en español de J20, J22, Down Converter y master; colores base por placa en los visores; generador de iBOM sin KiCad
    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
2026-10-20 Placas individuales: DRC revisado, .kicad_pro y Gerber en español listo para fabricar
    - .kicad_pcb actualizados (J20 sin segmento de longitud 0, J7 pad 16 sólido en Down Converter, ajustes de máscara)
    - Nuevo .kicad_pro por placa (cobre-borde 0,2 mm, alivios térmicos como aviso)
    - fabricacion/*_gerber.zip: Gerbers + taladros PTH/NPTH desde el .kicad_pcb vigente; reemplazan los zips antiguos (los originales siguen en originales/)
    - iBOM en español regenerado
    - README y LEEME actualizados
    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
    [imac_g3_333mhz_slot_loading_J20_adapter_board_es.kicad_pcb, imac_g3_down_converter_board_adapter_es.kicad_pcb, imac_g3_slot_loading_J22_adapter_board_es.kicad_pcb]
2026-10-20 Placas individuales: expansión de máscara 0,051 mm (como el diseño original)
    - pad_to_mask_clearance 0,051 en los tres .kicad_pcb
    - Gerbers de máscara ajustados con utilidades/expandir_mascara.py y verificados contra los Gerbers originales (diferencia de área de ~19 mm² a ~1,7 mm² por capa)
    - LEEME de fabricacion y utilidades actualizados
    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
    [imac_g3_333mhz_slot_loading_J20_adapter_board_es.kicad_pcb, imac_g3_down_converter_board_adapter_es.kicad_pcb, imac_g3_slot_loading_J22_adapter_board_es.kicad_pcb]
2026-10-21 Guía interactiva paso a paso (GitHub Pages)
    Sitio estático en la raíz (index.html + sitio/): 12 fases con fotos de las
    guías originales, plan personalizado, cables, jumpers, alimentación,
    configuración Pi 5, calibración, multímetro, diagnóstico, descargas,
    glosario y búsqueda. Progreso en localStorage; sin paso de compilación.
    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
2026-10-21 Corrige el botón «Seguir con la guía» del plan
    Era un enlace al primer paso pendiente; si coincidía con la URL actual no
    pasaba nada. Ahora es un botón que va al siguiente paso después del plan
    y hace scroll aunque el hash no cambie.
    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
    [widgets.js]
2026-10-21 Imágenes traducidas al español y enlace del manual de Apple
    - 19 imágenes con texto en inglés traducidas (esquemas, fotos rotuladas,
    osciloscopio y captura del manual) en docs/traducciones/imagenes/,
    generadas con utilidades/traducir_imagenes.py. Los originales no se tocan.
    - La guía interactiva y docs/guia_macberry_pi.md usan las versiones en
    español; nuevo grupo de descargas con las imágenes.
    - El enlace al manual de servicio de Apple (S3, caído) apunta ahora a iFixit
    y al wiki del proyecto original, y abre en pestaña nueva.
    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
