JJaroll/MacBerry-Pi/(notices)

Notices in the files:
hardware/placas_individuales/J20_video/imac_g3_333mhz_slot_loading_J20_adapter_board_es.kicad_pcb:
Original: qbancoffee/imac_g3_ivad_board_init (LGPL-3.0)
README.md:
Bezel: CC BY-NC 4.0
hardware/placas_individuales/J22_frontal_audio/imac_g3_slot_loading_J22_adapter_board_es.kicad_pcb:
Original: qbancoffee (LGPL-3.0) - Traduccion y firma: JJaroll.dev
